krisxia0506/voxu/hardware/enclosure/README.md

# VOXU P2S 外壳 V4：上下壳卡扣，螺丝可选加固

按实物反馈更新的工程样机。只装 **51.45 × 28.33 mm ESP32 开发板、14 mm 圆形 INMP441 与直接焊接的排线**。拆掉两块板的排针，不再预留杜邦插头空间；有线供电，无电池、电源开关。

**本轮需要重打底座和上盖，配套使用。** 正常合盖使用四个一体打印卡扣，无需螺丝；四角原螺丝孔保留作额外加固。麦克风槽、按帽及默认最长顶杆保持原结构，按钮和可选麦克风框可以继续使用。用户已确认 USB 对位和麦克风直接卡装合适；新卡扣的实际手感、回弹和耐用性仍待验证。下载包内不含 G-code。

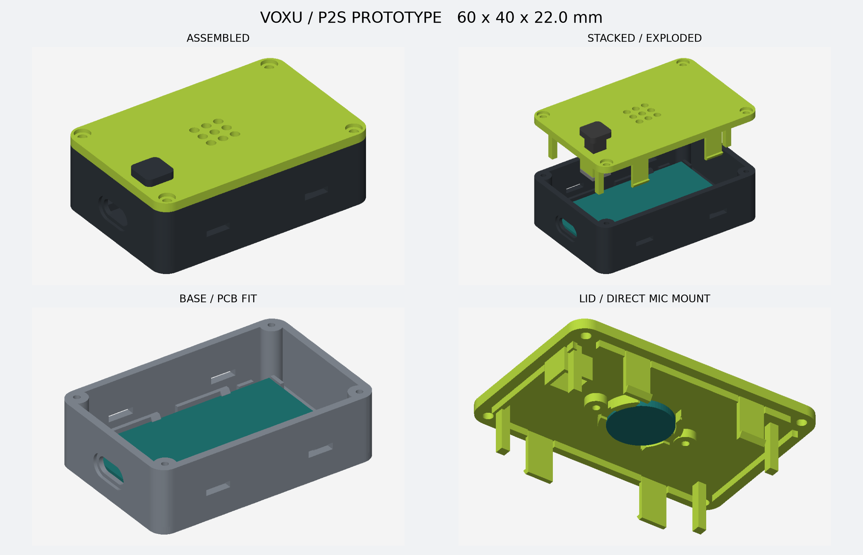
[picture p6: hardware/enclosure/preview.png]
实际 CAD 预览


## 这次改了什么

| 实物问题 | 当前结构 |
|---|---|
| 上下壳免螺丝安装 | 两条长边各 2 个卡扣，合盖时斜面导入并扣住侧壁；保留原螺丝孔，侧面留解锁孔便于拆盖 |
| 麦克风固定 | 用户实测现有槽可直接卡住，槽与螺钉座保持不变；`mic-clamp` 仅作可选加固 |
| 主板松动 | 4 个侧向弹性卡舌约束 PCB 边缘，无需靠上盖螺钉压紧才能定位；下方四个托台从 3 × 3 mm 向板内扩大为 6 × 6 mm |
| 按钮晃动、顶杆错位 | 5 mm 方形滑杆、5.4 mm 方孔，导向长度从 2.4 mm 增加到 8.0 mm；导向末端靠近 BOOT，限制倾斜和旋转 |
| 盒子太长 | 麦克风叠放在主板中央上方，长度从 88 mm 缩到 60 mm，避开远端天线区域；取消排针空间并降低托台 |
| USB 接口太深、开孔太大 | 按用户提供的突出 PCB 2 mm，主板前缘距壳外端面 2.4 mm，接口前端约内缩 0.4 mm；圆角通孔 9.8 × 4.2 mm |
| 9 个小孔被糊住 | 每孔直径从 1.2 mm 增加到 2.4 mm，孔距 3.4 mm，孔间保留 1 mm 实体 |

壳体外廓 **60 × 40 × 19.4 mm**，含未按下的按钮总高约 **22 mm**。上盖外表面平整，朝下贴板打印；无外侧护脊。

## 零件和额外材料

| 文件 | 数量 | 说明 |
|---|---:|---|
| `base.stl` | 1，本次重打 | 保留主板卡舌和 6 × 6 mm 托台，新增上盖卡扣接收/解锁孔 |
| `lid.stl` | 1，本次重打 | 新增 4 个一体卡扣，平面外表面仍朝下打印 |
| `mic-clamp.stl` | 可选 | 麦克风额外加固框，正常直接卡装时无需打印 |
| `button-cap.stl` | 1 | 按帽与长方形滑杆一体打印 |
| `button-pin.stl` | 1，可沿用旧最长件 | 用户实测所需的最长顶杆，已设为唯一默认件 |

上下壳正常卡合**不需要螺丝**。需要进一步加固时可加 **4 枚 M2×8 mm 塑料自攻螺钉**；麦克风加固框另可选 **2 枚 M2×5 mm 塑料自攻螺钉**。按帽与顶杆仍用少量适配打印材料的胶固定。上盖螺钉头径应不大于 4 mm。不要沿用旧版的 M2×10 当成新版指定长度。

## 打印顺序

P2S、0.4 mm 喷嘴、PLA、0.20 mm 层高、3 道墙、4 层顶底、15% 填充作为试装起点；需要在 Bambu Studio 选择实际材料。所有 STL 单位 mm，已摆正并落在 Z=0。

1. 从零组装只需底座、上盖、按帽和默认顶杆，共 4 件；麦克风加固框是可选件。已有旧版的用户本轮重打底座和上盖，旧最长顶杆及按帽继续使用。
2. `lid` 已按外表面朝下导出，内侧立柱、导向套、麦克风座和一体卡扣向上打印；关闭支撑，检查卡钩短悬挑是否成形。`button-cap` 顶面朝下、方杆向上，`mic-clamp` 平放，也关闭支撑。
3. 底座正放，卡舌横向弹臂下方与底板之间有 2 mm 间隙，需检查并清理该处支撑，让弹臂可向外弯曲，不能被支撑粘死。USB 窗口桥接和顶杆挡边悬挑也需检查支撑。首轮采用已切片验证的启用支撑配置。
4. 切片预览检查首层孔、孔口毛刺和支撑残留。几何检查不替代实际材料收缩、公差与打印质量验证。

## 装配顺序

1. **断电，拆排针并焊排线。** 将焊脚剪平，排线沿板侧绕到上盖；不能让排线横跨 BOOT 或压在 USB 接口、天线和麦克风声孔上。
2. 主板元件面朝上，先让 USB 对准端部开口，再把 PCB 四角压到扩大后的托台上。四个卡舌经斜面向外让位后扣住 PCB 两侧上缘。若卡舌不动，先清掉其下方支撑，不能强压 PCB。PCB 底面距壳底外表面 4 mm，底板厚 2 mm；焊点和线不能把 PCB 顶起来。取板时先用塑料片轻拨开卡舌再抬板，不要硬拔。
3. 上盖翻过来，将麦克风直接卡入已验证的定位座，无需加固框：**PCB 小声孔朝盖面，金属封装朝壳内**。将圆板旋转到两排焊点朝两个接线缺口。
4. 仅需进一步加固时放上 `mic-clamp`，两根向内伸出的短舌压住 PCB 左右边缘，中央大孔让开金属封装和焊点。用两枚 M2×5 螺钉交替轻拧，只拧到圆板不晃；不要压弯 PCB。压片按 1.6 mm PCB 厚度设计，若实际板更薄而有松动，可在两个边缘接触点各加薄垫片，避开声孔和焊点。
5. 从外侧插入按帽方杆，从内侧插入顶杆，先干试配合，再在顶杆短端末端点极少量胶，插入按帽孔至挡边贴住方杆底端。**必须穿过上盖后再粘接，不能在壳外先粘死**；胶不得流入方形导向孔。孔径 3.4 mm 配 3.0 mm 轴，带入口导角。胶固化后挡边与滑杆应成刚性整体，否则仍可能晃动。
6. 使用用户实测可用的最长顶杆（现名 `button-pin.stl`）。合盖前确认接触脚正对 BOOT，松手能回弹；主板卡到位后重新验证一次。不再提供多个长度供选。
7. 排线避开四个上盖卡扣。将上盖定位边对齐底座，在四个卡扣对应的位置逐一轻压，让斜面导入、卡钩进入侧壁小窗口。确认四周合缝、四个钩均扣住，再轻提上盖检查固定。若某处不入位，先检查毛刺/线材，不要用螺丝强行拉入卡扣。
8. 需要额外加固时再用原四角孔拧入 M2×8 螺钉；只需轻紧，不要使壳体变形。松开 BOOT 后通电，验证开始/结束与录音。
9. 拆盖时先卸掉可选加固螺丝、断电。从侧面小窗口用薄塑料片将对应卡钩向壳内推，同时轻抬该位置并用另一片塑料片保持约 1.5–2 mm 缝隙，逐一释放其余卡扣。只推卡钩，不要把工具深入壳内碰到排线/开发板；不要直接硬撬上盖。

## 尺寸来源与边界

- 用户确认开发板 51.45 × 28.33 mm、圆形麦克风 14 mm，并说明 USB-C 接口比 PCB 突出约 **2 mm**，本版据此前移主板。
- USB-C 插接界面有标准；本版参考 [GCT USB4105 厂商尺寸图](https://media.digikey.com/pdf/Data%20Sheets/GCT%20PDFs/USB4105%20-%20Product%20Drawing.pdf) 的金属壳约 **8.94 × 3.31 mm**，设计 **9.8 × 4.2 mm** 圆角孔。外侧另有深 0.8 mm、11.8 × 6.2 mm 的浅避让，让线头外包胶靠近端面。厂商图纸不是对实际板载连接器料号的认定。
- PCB 前缘位置 = `usb_protrusion + usb_front_recess` = 2 + 0.4 = 2.4 mm。接口高度暂按贴装在 PCB 元件面上设置，用实际底座验证插接。实际线头包胶外形并非所有线材相同。
- 上下壳新增 4 个卡扣，宽 6 mm、厚 1 mm、悬臂长约 10.2 mm；钩向外凸 0.8 mm，与底座内壁咬合约 0.5 mm。窗口每侧留 0.3 mm 横向间隙、上下各 0.2 mm 间隙。释放间隙检查采用 0.9 mm 端部内移包络，仅证明几何可通过，不代表有限元或材料寿命验证。
- 主板 4 个卡舌采用 12 mm 横向弹臂、1 mm 壁厚，卡唇在 PCB 上表面上方名义留 0.05 mm 间隙并向内覆盖 0.5 mm；几何检查确认能阻挡板子上抬。打印弹性、装入力与长期耐用性仍需实物验证。
- 两块 PCB 厚度暂按 1.6 mm；主板中央器件预留高 4.5 mm，麦克风封装碰撞检查使用 6 × 4 × 1.2 mm 包络，麦克风上方声腔间隙 0.4 mm。真实元件及焊线仍需试装。
- BOOT 中心暂按 PCB USB 端角向内 (3.1, 6.0) mm，高出 PCB 3.2 mm；按钮初始空隙 0.15 mm、按帽向下限位 0.6 mm，为可调整试装值。
- 平面尺寸参考：[开发板图](https://embedded-systems-design.github.io/overview-of-the-esp32-devkit-doit-v1/ESP32_dimension.png)、[麦克风图](https://components101.com/sites/default/files/inline-images/INMP441-Dimensions.jpg)。

## 生成和检查

```sh
python3 -m venv /tmp/voxu-cad
/tmp/voxu-cad/bin/pip install -r hardware/enclosure/requirements.txt
/tmp/voxu-cad/bin/python hardware/enclosure/generate.py
```

修改 `parameters.json` 再生成 STL、预览和压缩包。`validation.json` 包括 5 个零件（4 个必需件及 1 个可选麦克风加固框）的封闭性、单连通、正体积、USB 参考外壳/PCB/麦克风及压片装配干涉、默认最长顶杆 7 个行程位置、21 个插入位置、9 个声孔贯穿与主板卡舌阻挡上抬检查，以及 4 个外壳卡扣的锁止与 25 个拆出位置的释放间隙检查。

切片证据见 `slicer-result.json`：V4 上盖关闭支撑切片 Success，无支撑路径，约 27.6 分钟、6.8 g；新底座启用支撑切片 Success，约 35.3 分钟、13.5 g。未改变的按帽、最长顶杆和可选麦克风框不重复切片。卡扣的实际扣合、释放手感和耐用性尚未实物验证。

CLI 的机器指令解析曾出现 `Invalid T command (T65535)`，不交付其 G-code；请在 Bambu Studio 中从 STL 重新切片。几何、切片、实物装配与实际录音验证分别报告，当前仍是待实物验证的试装版。
