krisxia0506/voxu/hardware/integrated-pcba/economy-e1/README.md

# E1 经济型电气候选：超预算，未放行

核价日期：2026-10-24。目标为两块全部厂家焊接、合计160元以内，不付款。新电池按已确认要求单列。当前没有满足此目标的完整可生产方案；本目录不能下单制造。

## 已落实的改动

- 主控由WROOM-32E改为ESP32-PICO-V3（C967022，7×7 mm TFQFN48-EP）。依据[乐鑫数据手册v1.4](https://www.espressif.com/sites/default/files/documentation/esp32-pico_series_datasheet_en.pdf)映射电源、启动、UART、GPIO26/33及保留脚，保留经典蓝牙HFP/HID所需的ESP32架构。4MB Flash与晶振集成，但仍需PCB天线和匹配验证。
- 保留PDM麦克风、单USB-C充电/下载、电池电源路径、关机充电、USB域断电隔离。Type-C短边居中的机械要求继续有效；E1尚无新布局，不能把A2预览当成E1。
- 阻容优先采用基础库；ISET由8.66k单电阻改为8.2k+470Ω串联。含1%容差的最大电阻8756.7Ω，低于所引用的8900Ω推荐上限；沿用电流系数容差的充电电流计算为91.02–113.59mA。
- 增加局部去耦、Flash电压启动下拉及初始RF串联0Ω位置。共71位号、29料号。RF的0Ω只是调试初值，两个并联调谐位置暂不装，不能宣称无需射频调试。
- A2原生EDA工程、PCB和STEP备份保留。这里的KiCad原理图是交换草稿，尚未导入/验证为立创EDA专业版原生工程。

## 两块的费用：哪些已核，哪些还缺

在嘉立创原Y5草稿试换PICO-V3后，经济型、仅顶层、2片贴3片不贴，64/64位号可以选中。最终提交页显示：

| 费用 | 两块合计（元） |
|---|---:|
| 元件采购（含税、损耗、最低出库量） | 171.64 |
| 换料：12种×20 | 240.00 |
| 工程 | 50.00 |
| SMT焊盘 | 5.70 |
| X-RAY | 20.00 |
| DFM确认 | 3.00 |
| 氮气 | 5.20 |
| 页面SMT总计 | **495.54** |

这不是E1整板报价：旧Gerber/CPL仍是WROOM封装，且没有新增7个位号。不得提交此试算草稿。逐料号数量、价格复算171.6395元，与页面171.64元一致。

`costed-bom.csv`覆盖E1全部71位号、两板142个安装件，补入R25/R26/R27/C22–C25，并用基础库串联电阻替代R18。沿用当前已核价格/MOQ后，完整元件预算为**171.9707元**，预计剩11种收费料号、换料220元。新增件没有以0元略过；这是手工数量复算，未获新版BOM平台最终确认。

若暂按旧板PCB33元和试算加工费继承，E1账面参考为：171.97 + 220 + 50 + 5.70 + 20 + 3 + 5.20 + 33 = **508.87元**。这是跨版本预算参照，**不是最终总价、最低价或可成交报价**。新布局会改变焊点/加工核算，PCB券也未对新版验证。

| 未结清项目 | 状态；不得按0元算 |
|---|---|
| 新PCB、钢网/插件/分板等适用费用 | 必须用E1 Gerber和CPL重算；当前经济型页面未另列钢网/插件费 |
| PCB券 | 已领两张均为PCB券，SMT券为0；新订单是否抵扣尚未验证 |
| 运费 | 旧PCB报价京东特惠包邮；E1最终订单未确认，不能跨版本保证 |
| 固件/CP2102N配置写入 | 尚无验证配置镜像或厂家工序报价；焊好不等于烧录调试完成 |
| 射频匹配追加元件 | 实板/外壳调谐未完成，最终值和费用未定 |
| 两块新电池与匹配插头 | 按用户此前要求另计；型号、NTC、极性和价格未定 |

当前PICO路线即使免掉全部换料费，元件171.97元本身也超160元；不能承诺通过优惠满足预算。这只否定当前E1候选，不证明其他架构的全局最低价。

## 具体未完成项

1. 封装绑定、PCB天线、布局布线、原生ERC/DRC/DFM、3D及实板RF/电源/音频验证。U1/L1等未资格确认的封装留空，不沿用错误焊盘。
2. 输出电容的偏压有效容量、NRND供应风险、功率电感热参数及焊盘验证。保留功能是设计目标，尚未实板证明。
3. 旧平台坐标拒绝新增位号，明确提示“位号R26未能从位号文件中识别”。不能靠给新器件编造旧坐标获取制造放行。
4. 独立BOM上传尝试未收到文件选择事件，上传未成功；未声称已导入71位号。新版实际整板总价仍未取得。

## 本地验证

`python3 hardware/integrated-pcba/economy-e1/generate.py`检查引脚映射、保留脚、71件数量和ISET电阻容差。`checks.json`明确标记PCB NOT ROUTED、RF NOT VERIFIED、native ERC NOT RUN、manufacturing_release=false。该检查不能替代原生EDA电气检查或实板功能验证。

超预算，制作暂缓。没有新提交SMT订单，没有付款。
