krisxia0506/voxu/V1-DESIGN.md

# Voice Puck 外壳：当前 V4 工程样机

2026-09-29 最初选定 M 双层护脊外观；随后根据用户打印和装配反馈改为平面上盖，并在本轮改为焊线叠放的紧凑结构。历史概念图不再作为当前机械尺寸依据。

当前目标：拓竹 P2S；51.45 × 28.33 mm 开发板、14 mm 圆形 INMP441；去掉排针直接焊排线。板载 USB-C 有线供电，无电池、电源开关；外部按钮机械触动 BOOT。

[STL 下载包](hardware/enclosure/voxu-p2s-prototype.zip) · [打印装配说明](hardware/enclosure/README.md) · [参数](hardware/enclosure/parameters.json)

实际 CAD

- 壳体 60 × 40 × 19.4 mm，含按钮总高约 22 mm；麦克风叠放在主板中央上方，替代原 88 mm 长盒。
- 麦克风已由用户验证可直接卡入原槽，保留螺钉座及可选压片；拾音孔直径从 1.2 增到 2.4 mm，保留 9 孔。
- BOOT 使用 8.0 mm 长的方形导向套约束滑杆，内侧短顶杆胶接后防脱。
- 根据用户量到 USB-C 突出 PCB 约 2 mm，将主板前缘移至距壳外端面 2.4 mm；接口前端约内缩 0.4 mm，圆角通孔为 9.8 × 4.2 mm。
- 上盖外面平整，贴板打印。V4 上下壳增加四个可解锁卡扣，免螺丝压合，保留原四角螺丝孔供加固；本轮需重打底座和上盖，按帽与默认最长顶杆不变。

**状态：可打印试装模型，尚未实物验收。** PCB 厚度、BOOT 中心/高度、连接器安装高度及焊线空间仍有明确标注的假设。提供 4 个必需件和 1 个可选麦克风加固框，不提供 test 组件；主板新增 4 个侧向卡舌，下方托台由 3 × 3 mm 向内增至 6 × 6 mm。用户已验证麦克风卡装、USB 对位和最长顶杆，主板卡舌及新增上下壳卡扣的实物固定、释放和耐用性仍待验证。
