krisxia0506/voxu/hardware/integrated-pcba/procurement/economic-feasibility.md

# 经济型降本核算与制作暂停条件

核查日期：2026-10-24。用户最终要求：两块完整焊接 PCBA 合计 **160 元硬上限**，全部厂家焊接，超出暂缓制作。新电池按此前要求另计，但仍必须先列清；不付款。未提交新的 PCB 或 SMT 订单，原 Y5 未付款，旧 SMT 草稿不提交。

## 结论

**尚未找到满足预算且保留全部功能的经济型方案。已新增 E1 经济型电气候选与 71 位号 BOM；PCB 改版未完成，也没有新的完整成品实时报价。** 以下为选型门槛核算，不是可生产 BOM 或最终账单。现有 A2 源文件和 3D 备份继续保留，禁止将其视为经济型新版。

现有固件要求 Bluetooth Classic HFP + HID。不能用便宜的 ESP32-C3/S3 直接替代；其不支持 Classic，见 [乐鑫 Bluetooth 架构表](https://docs.espressif.com/projects/esp-idf/en/latest/esp32s3/api-guides/bt-architecture/overview.html)。改裸芯片还需要 Flash、晶振、射频匹配和天线设计验证，并非更换一个封装。

## 实查候选

国内嘉立创 SMT 目录网页人工可见结果；库存和含税价格只代表查询时点。没有“标准型专用”标签只表示可继续审核，**不等于已通过经济型订单匹配**。没有采购或预留这些候选。

| 料号 | 型号 | 页面单价/元 | 页面库存 | 资格与处理 |
| --- | --- | ---: | ---: | --- |
| [C701341](https://www.jlc-smt.com/lcsc/detail/C701341.html) | ESP32-WROOM-32E-N4 | 22.97 | 37863 | 标准型专用，旧方案不能只切换经济型选项 |
| [C19949066](https://www.jlc-smt.com/lcsc/detail/C19949066.html) | DOIT ESP32-32E-N4 | 19.07 | 845 | 标准型专用，不能解决经济型资格 |
| [C2764058](https://www.jlc-smt.com/lcsc/detail/C2764058.html) | ESP32-SL | 13.55 | 0 | 标准型专用、常规库存无货；共享库存2颗约29.64元，不采用 |
| [C193707](https://www.jlc-smt.com/lcsc/detail/C193707.html) | ESP32-PICO-D4 | 25.77 | 8466 | 标准型专用 |
| [C967022](https://www.jlc-smt.com/lcsc/detail/C967022.html) | ESP32-PICO-V3 | 25.48 | 798 | 扩展库、未见标准型专用标签；集成4MB Flash，需重新做射频及PCB |
| [C129733](https://www.jlc-smt.com/lcsc/detail/C129733.html) | ESP32-D0WDQ6 | 14.42 | 88 | 扩展库、未见标准型专用标签；需外部Flash、晶振、射频外围 |
| [C967020](https://www.jlc-smt.com/lcsc/detail/C967020.html) | ESP32-D0WDQ6-V3 | 18.29 | 2152 | 扩展库、未见标准型专用标签；同样需外部外围 |
| [C109322](https://www.jlc-smt.com/lcsc/detail/C109322.html) | TPS63070RNMR | 7.48 | 37038 | 扩展库、未见标准型专用标签；原电源候选 |

麦克风 SPH0655LM4H-1-8 / C22376158 沿用此前实际采购窗口 4.64 元快照，并非本轮重新预留；详见 microphone-selection.md。仍需下单前刷新。

## 预算门槛：先核算，再决定是否改版

[官方价格入口](https://www.jlc.com/)公开50元工程费起；[扩展库收费通知](https://www.jlc.com/portal/q7i36905.html)规定经济型20元/种。最终仍应以实际匹配和优惠抵扣后的页面为准。

以 PICO-V3 + 现有麦克风 + TPS63070 的三个扩展料号为例，不计损耗：

- 两块的这三颗芯片：2 × (25.48 + 4.64 + 7.48) = **75.20 元**。
- 工程费预算50元，三种换料费预算60元。
- 仅上述项目合计 **185.20 元**，已超160元25.20元。
- 尚未加入充电、UART、隔离、电感、阻容、连接器、开关、射频外围、PCB、焊点、检测、包装、运费、损耗及最低采购量。

这只排除了该候选组合在无减免下满足预算的可能，**不是证明所有经济型方案都不可能**。裸 ESP32-D0WDQ6 单价更低，但新增外围和扩展料号费用尚未核定，不能将14.42元当作完整主控成本。

## 盲盒领取后的复核（2026-10-24）

两次微信验证后，本月两张券已领取。客户中心“未使用/全部优惠券”共2条，均为 **PCB订单可用／1-6层板OSP EDA专用券**，有效期2026-10-24至2026-11-23；“未使用/SMT”共0条。第一张领取弹窗也明确“免费PCB，不免费SMT”。因此本次没有取得SMT加工减免，不能把工程或换料费抵扣为零。未使用券下单，也未付款。

[账户优惠券入口](https://member.jlc.com/integrated/content/couponList)。PCB是否能最终免单仍取决于新订单工艺和平台校验；两张券不能当作同一单的两次现金抵扣。

## 官方免换料费清单核对

已通过[专区](https://www.jlc-smt.com/lcsc/basic)“下载免换料费器件清单”取得xlsx，包含1586个器件；与旧BOM精确料号相交，11种/41个位号在清单内，17种/23个位号不在清单内。逐项结果见 `free-feeder-audit.csv`。清单不含库存和单价，也不证明经济型装配资格；不得据此宣布可生产。

可继续资格审核的替代候选（尚未写入生产BOM）：

| 原位置/功能 | 清单内候选 | 仍需审核 |
| --- | --- | --- |
| R5 2.21k | C4190，0603 2.2k 1% | 原电阻用途和电流裕量；相同电压下电流增加约0.455% |
| R18 8.66k ISET | 保留 C23114；基础库候选为8.2k+470Ω串联 | 撤销9.1k候选：超过设计引用的8.9k推荐上限。串联方案需新增位号和布局验证 |
| C1 1uF | C15849，0603 1uF 50V | 介质、偏压后容量和用途 |
| C15/C16 10uF | C15850，0805 10uF 25V（旧板已有） | 电源要求的有效容量、纹波与温度 |
| C17/C21 10uF | C96446，0603 10uF 25V | 有效容量、ESR和布局 |
| C18/C19/C20 22uF | C45783，0805 22uF 25V | 偏压后有效容量、容差及稳压器稳定性 |
| USB UART | C6568，CP2102-GMR | 不能直接替换CP2102N的充电检测/电流控制，需改电路与封装 |

前6行若全部通过，可减少6种收费料号，按经济型20元/种可少120元换料预算。但这是相对尚未优化的经济型BOM，并非从旧标准型224元换料费中扣120元，更不代表两块成品已低于160元。

## 硬上限复算与暂停依据

即使暂按PCB券完全抵扣板费，现有PICO候选的185.20元小计本来就未包含PCB，所以不会因只拿到PCB券而降到160元内。

另用本日已查的更低价裸芯片ESP32-D0WDQ6核算：若保留现选数字麦克风、USB-C及电池插座，并按四种非免换料料号计算，则工程50 + 换料4×20 + 两颗主控2×14.42 + 两颗麦克风2×4.64 = **168.12元**。此处连连接器本身、Flash、晶振、射频、电源、其余元件、焊点、损耗和运费均未加入；不是完整报价，也不是所有可能设计的理论最低价。它说明当前已查候选路线即使阻容全部免换料，仍不能满足160元。

因此继续保持制作暂停；没有以未完成的替代BOM提交订单。全功能合格经济型改版和完整实际总价仍未取得，不声称完成。若要继续寻找不同主控/模拟麦克风/电源架构，须重新评估功能和录音性能，不能将当前小计包装为可下单方案。

## 旧方案费用复算（历史报价，不用于新下单）

64个贴装位号单价来自 jlc-order-review.json，装在一块上的元件合计94.5043元，两块189.0086元。平台元件实际计价243.19元，差额54.1814元包含采购数量/损耗影响，不能按只买恰好两份计算。

| 旧标准型两块项目 | 元 |
| --- | ---: |
| 元件采购 | 243.19 |
| 工程 | 150.00 |
| 换料 | 224.00 |
| 钢网 | 50.00 |
| 焊点 | 5.66 |
| X-ray | 20.00 |
| 包装 | 3.01 |
| 差价（平台未解释明细） | 54.23 |
| DFM确认 | 3.00 |
| SMT小计 | 753.09 |
| PCB参考价 | 33.00 |
| 合计参考 | **786.09** |

电池、烧录及最终运费/审核调整未包含。旧PCB33元含20元板费、10元品质赔付、3元生产稿复核；不能直接将旧PCB金额套入新版，也不能把非必要附加服务当作必选费用。

## 后续降本门槛及未完成项

1. 首先确认经济型可贴主控；保留 Classic 功能。只有成本表可落在160元内才进入该路线完整改版。
2. 优先消除不必要扩展料号：2.21k/8.66k电阻改常用基础库阻值须重算VBUS检测分压/充电电流；电容统一基础库须核对偏压后有效容量和电源稳定性；不能只按标称容量替换。
3. 原21.55元 Coilcraft 电感是重点降本项；替代须满足饱和电流、温升电流、DCR和开关频率，不能换成普通射频0402电感。
4. UART便宜替换不能丢失USB限流控制、断电隔离；CP2102N配置及烧录成本仍待闭合。充电器须保留合规电流与真实电池温度监测。
5. 全部开关、Type-C和电池连接器都必须厂家焊好；不把手焊元件从报价删掉来满足预算。Type-C短边居中继续保留。
6. 最终费用必须逐项列出：最低PCB批量、两块装配、采购损耗/MOQ、换料、工程、钢网、检测、包装运费、烧录及电池。未知项保持未知，不填零。160元上限不得以多做板子后摊薄单价代替。

**当前制作暂缓，未放行。** 不因需要平台后续审核或付款后DFM而付款；新完整BOM、经济型匹配报价、制造检查和实板验证均未完成。

## 全部64位号核价试验（2026-10-24，未提交）

本次在平台报价草稿中实际替换10个位号，保留全部64个贴装位置；源PCB未改，草稿禁止直接提交制造。

- R5：C22903 → C4190（2.2k基础库，VBUS检测分压）。
- C1：C29936 → C15849（1uF 50V X5R基础库）。
- C15/C16：C109040 → C15850（与已有0805 10uF合并）。
- C17/C21：C386081 → C96446（0603 10uF基础库）。
- C18/C19/C20：C258782 → C45783（0805 22uF基础库）。
- L1：C3033018 → C5127348（1.5uH，6A Isat，46mΩ，4.6×4.2mm，0.382元；必须重新绑定封装和检查电源，尚未资格签核）。

阻容替换减少5种扩展料号。R18没有采用错误的9.1k候选。输出电容的偏压后有效容量/温度范围尚待确认，C45783厂家标为NRND；便宜电感的温升规格在目录标题与描述有差异。这些是成本候选而非制造放行。

其余器件未删除：主控、麦克风、USB-UART、3颗断电隔离缓冲、充电和升降压、电源保护、全部开关及连接器均包含。CP2102不能直接替代CP2102N的充电识别；TP4056不能直接替代带电源路径和温度监测的BQ24075；没有把这些非等价更换算作已优化。

完整明细见 cost-trial-all-parts.csv：64个位号、27种料号，128个实际焊接元件，按平台采购损耗/MOQ计价，逐料号去重后合计185.1188元，与平台185.12元一致。表内重复位号共享同种料的采购数量，不能重复累加。

| 完整BOM核价试验项目 | CNY | 性质 |
| --- | ---: | --- |
| 全部元件采购含损耗/MOQ | 185.12 | 平台实时显示，已逐项复算 |
| SMT加工 | 447.67 | 两块、标准型、仅顶层、普通2-3天；平台汇总 |
| SMT合计 | 632.79 | 未提交核价草稿，不是已审核可生产报价 |
| 旧PCB订单参考 | 33.00 | 历史订单含可选附加项，不是本轮最低板价 |
| 沿用旧PCB金额的合计 | 665.79 | 仅跨单参考，不得称最低到手价 |
| PCB券抵扣、最终运费、烧录 | 未确认 | 不填零；电池按用户要求另计 |

旧SMT753.09元与试算632.79元相比少120.30元。页面另显示经济型485.25元，但现用WROOM在经济型不可选；这个数字不能冒充两块完整焊好的经济型价格。切换产品类型曾重置贴装数量，已恢复并检查两块、顶层、普通交期；未以五块报价摊薄。

**尚未完成用户要求的“合格经济型完整最低总价”。** 本次取得的是覆盖全BOM的标准型降本试算，不能把它说成最低方案，也不能把632.79元当包含PCB和运费的到手总价。当前路线显著超160元，继续暂停制作、不付款。若继续经济型路线，需要完成支持Classic的主控/RF改版、替代元件资格核验，再获取全部费用；现有文件和旧订单都不应放行。

## E1 经济型实际选料与全 BOM 预算（本轮更新）

见 `../economy-e1/README.md`。C967022 / ESP32-PICO-V3 已在两块、仅顶层、经济型模式下通过平台选料，64/64 位号可选；此结论取代上文“只查到目录标签”的早期状态。最终提交页试算495.54元，但使用旧A2坐标，不能制造或称为E1最终报价。

E1 已生成71位号电气候选、原理图交换文件和29料号完整成本表，两板142个安装件，含已知损耗/MOQ的元件预算171.9707元。R18改为8.2k+470Ω串联，换料预算从240降为220元。其余加工、PCB、运费和配置工序的核价状态逐项列在E1说明中；未把缺失费用记零。未下单、未付款，继续因160元上限暂缓制作。

额外发现免换料清单内的USB ESD候选C7420376 / SRV05-4（0.494元，库存128347，损耗4、最小贴装5，2026-10-24选料页），但尚未验证引脚和USB电气规格，未当成等价替代写进E1。不是所有保护器件都没有免换料候选。
