krisxia0506/voxu/hardware/integrated-pcba/procurement/microphone-selection.md

# 麦克风供货与性价比选择

2026-10-23，按用户允许改用嘉立创现货、降低成本的要求，选择 **Knowles SPH0655LM4H-1-8，C22376158** 作为下一版麦克风。尚未采购或预留库存，未付款。

## 国内 SMT 实查

| 型号 | 含税单颗价（1+） | 购买窗口可预售库存 | 页面换料费 | 判断 |
| --- | ---: | ---: | --- | --- |
| [SPH0655LM4H-1-8](https://www.jlc-smt.com/lcsc/detail/C22376158.html) | ¥4.64 | 3482 | 经济型 ¥20 / 标准型 ¥8 | 首选，PDM，标称 66 dB |
| [MSM261DGT003](https://www.jlc-smt.com/lcsc/detail/C48227730.html) | ¥5.47 | 2513 | 经济型 ¥20 / 标准型 ¥8 | 备选，PDM，目录 64 dB |

详情页库存总量分别为 3951、2829，不能将总量等同可购买量。以上以打开购买窗口后显示的「可预售库存」为准；没有点击加入预订购物车或结算。价格与库存会变化。

I2S 搜索结果中，ICS-43434 C5656610 的 1+ 价为 ¥28.13、目录库存 4042；尚未复核其购买窗口，不作为已确认可购买的备选。GSA3526H10-B26-5PI2S-JSM C55497034 虽显示总量 5、参考价 ¥4.50，购买窗口只有预订且最低 12 颗，不能当即用现货。原 INMP441 与 MSM261S4030H0R 无可购买现货。

一块板使用一颗麦克风：仅该料的单颗价加页面经济型换料费为 **¥24.64**，标准型为 **¥12.64**。这两个数字均不是 SMT 总价，未包含损耗、最低备料数量、焊点、钢网、开机、PCB、运费，也未核定优惠。标准型其他固定费用可能不同，不能仅凭换料费判断整板更便宜。

## 电气依据与替换约束

厂家 [SPH0655LM4H-1 Rev D 数据手册（商城提供）](https://atta.szlcsc.com/upload/public/pdf/source/20250721/5475C98035E60ADDD1C93C8246A1E933.pdf) 第 2、3、5 页已核对：

- 供电范围 1.65–3.6 V，可接本板 3.3 V。商品标题的 1.8 V 是典型值，不是供电上限。
- PDM 单比特输出，底部进音；3.5 × 2.65 × 0.98 mm。封装与 INMP441 不同，必须替换准确焊盘并复核声孔。
- 正常模式时钟范围 1.1–4.8 MHz；低功耗模式 0.5–0.9 MHz。
- 正常模式在 1.536、2.4、3.072、4.8 MHz 的标称信噪比为 66 dB(A)，1.2 MHz 为 64.5 dB(A)。这些是规定条件下的典型值，不能承诺装板录音效果。
- 1.8 V、2.4 MHz 条件下典型电流 1 mA，灵敏度 -37 dBFS；需实测并调整录音增益，不能照搬 INMP441 的幅度转换。

当前 ESP32 的 I2S0 支持硬件 PDM-to-PCM，见 [ESP-IDF I2S 文档](https://docs.espressif.com/projects/esp-idf/en/release-v5.5/esp32/api-reference/peripherals/i2s.html)。可继续输出 16 kHz PCM，无需新增外部 ADC，但必须修改驱动与 PCB：

1. 使用 PDM RX、16 位 PCM，复核 SELECT 电平、采样边沿与左右槽映射。
2. 16 kHz 时应选 128 倍抽取（`I2S_PDM_DSR_16S`），得到 2.048 MHz 时钟。默认 64 倍为 1.024 MHz，落在本麦克风两工作模式之间，**不可直接沿用默认配置**。2.048 MHz 的实际 SNR 不按表中其他时钟点直接宣称为已验证值。
3. 时钟、数据与供电重新连接；原 I2S WS 不再使用。保留原 INMP441 面包板固件的独立构建配置。
4. 更换原理图、PCB 封装及 3D 模型，复核声孔、阻焊和钢网，重新跑网络比对与 DRC，重新导出 BOM/CPL/制造文件。
5. 再进行一块成品的实际报价和样板录音验证。

**实施状态：已落板。** 原生 U2、5 个逻辑引脚（GND 分为 4 块实体焊盘）、0.65 mm 非金属化声孔、3D 模型与 CPL 均已替换。声孔处旧控制线已绕行，重建双面地铜后 PCB DRC 为 141 项、0 问题（2026-10-23 22:24:13）。213 个连接引脚与规范电气清单逐项一致。原理图 DRC 为 0 错误、0 警告，三条连接器/开关机械焊盘映射信息另列。

`i2s-smoke` 和 `hfp-probe` 的新 `pcba-sph0655`、旧 `esp32dev` 四个构建全部通过。新配置使用 PDM RX、16 位 PCM、128 倍抽取、LEFT 槽，启动和唤醒后丢弃 40 ms 样本。编译不代表音频硬件已验证；声孔钢网/DFM、厂家贴装方向和实物录音测试仍待完成。
