krisxia0506/voxu/docs/superpowers/research/2026-09-30-rejected-modular-spec.md

> 历史存档：用户已于 2026-09-30 否决该大尺寸模块方案，并要求兼容多种充电器。以下不是当前设计，也不是采购/接线依据。当前规格见 [紧凑单口电池版](../specs/2026-09-30-single-usbc-battery-design.md)。

# VOXU 单 USB-C 电池版设计规格

日期：2026-09-30。基线：`7c86af2`（已合入 PR #3 外壳与 PR #4 自动重连）。

**状态：已按用户要求改为无模式切换的自动充电目标；自动识别电路尚未定型，尚未生成电池版 CAD、STL 或完成电气实测。**
本文中的尺寸和工作指标是后续实施的输入，不是实测结果。原 USB 版模型继续保留。

## 1. 已确认的目标

- 复用现有 ESP32-WROOM-32、30 针 USB-C 开发板及 14 mm 圆形 INMP441。
- 不更换主控，不丢失 BOOT 开始/结束操作和上次蓝牙设备自动重连功能。
- 电池运行目标为持续连接、使用麦克风约 4–6 小时；接受外壳加大。
- **复用开发板现有 USB-C 接口**进行充电、供电与刷机，不在外壳增加充电口。
- 主要电脑为用户已确认的 **MacBook 自带 USB-C**；仍需验证实际端口供电声明。
- **接电脑可充电、刷机，接充电器可充电，全程不用切换模式。** 保留原 USB 数据能力；不要求先用充电器恢复电量才能接电脑刷机。
- 支持供电能力足够时边充边用，以及关闭麦克风整机时充电。低功率端口自动降低充电电流；必须明确实测兼容范围，不能将电池持续放电称为边充边用。
- 交付明确料号的 BOM、接线/装配说明、可编辑 CAD 生成脚本、STL、实际 CAD 预览和打印包。
- 使用 P2S；延续平面上盖、麦克风固定座、BOOT 导向按键、可解锁卡扣与可选螺钉加固。

## 2. 实物证据与设计边界

用户实测开发板 51.45 × 28.33 mm、USB-C 前端突出 PCB 约 2 mm。照片可见 VIN、3V3、EN、BOOT、PWR、D2，布局符合 CH340 USB-C 的 30 针 DevKit V1 类板。

[Micro Robotics 板型资料](https://www.robotics.org.za/development-boards/ESP32-DEV)给出 51.5 × 28.5 mm、30 针、CH340 和 USB-C；作为板型识别参考，不代替用户尺寸。
[同类板实物追线记录](https://diyelectromusic.com/2024/12/07/esp32-wroom-mozzi-experimenter-pcb-design/)给出 USB VBUS → SS14 → VIN → 3.3 V 稳压器的电路，也明确存在 USB 与 VIN 直连的变体。

因此按下面的**电气节点契约**设计，不能仅凭网络图片指定用户板上的某个器件一定要拆。焊接前核对实际电源网属于装配验收项，不阻止 BOM、CAD 和说明的制作。

## 3. 选型与取舍

**BQ24074 负载分配充电板 + PowerBoost 1000 Basic 升压板暂作为电源路径候选，不是可直接采购装配的完整方案。** BQ24074 不会自行识别电脑/充电器及其允许电流；原来的手动模式方案已被用户否决，必须补齐自动识别与限流控制后才能冻结选型。此前讨论的 PowerBoost 1000C 也不能直接替代这一功能。

| 方案 | 判断 |
| --- | --- |
| BQ24074 + 独立可关断升压板 | 候选电源路径，尚缺自动识别控制；有公开原理图和 PCB，充电、输入限流、温度检测及系统开关各自可控；代价是两块板和较大的外壳 |
| PowerBoost 1000C 一体板 | 集成度较高，但默认充电/输入电流不能直接当作普通电脑 USB 端口已授权的大电流负载；本版不采用 |
| 定制充电升压 PCB | 可以集成自动识别与电源管理并减小体积；需要打板和电气验证，是否采用待可用模块调查后确定 |

### 候选 BOM（每台，尚不可直接按表装配）

| 元器件/模块 | 数量 | 本版规格与用途 |
| --- | ---: | --- |
| 现有 ESP32 开发板 | 1 | 去排针、焊短线，PCB 51.45 × 28.33 mm |
| 现有 INMP441 圆板 | 1 | 保持 GPIO26/25/33 与 3V3 接线 |
| [Adafruit BQ24074 #4755](https://www.adafruit.com/product/4755) | 1 | 单节 4.2 V 锂电充电、负载分配；PCB 源文件轮廓 38.10 × 33.02 mm；自带 USB-C/DC 插座藏在壳内，不接外部线 |
| [Adafruit PowerBoost 1000 Basic #2030](https://www.adafruit.com/product/2030) | 1 | 升压输出约 5.2 V，EN 拉低可断开输出；参考外廓 29 × 23 mm；不装随附 USB-A、JST 或接线端子，直接焊线 |
| [Adafruit 2500mAh 单节保护电池 #328](https://www.adafruit.com/product/328) | 1 | 标称 3.7 V，满电 4.2 V；参考尺寸 60 × 50 × 7.3 mm；允许充电电流不超过 1.2 A；自带保护与 JST-PH 插头 |
| [SPDT 滑动开关 #805](https://www.adafruit.com/product/805) | 1 | 仅控制运行开关；不设置电脑/充电器模式开关 |
| [10 kΩ NTC #372](https://www.adafruit.com/product/372) | 1 | 按 #4755 指南接 THERM；贴靠电池大面，绝缘固定，不压迫软包 |
| 自动 USB 电源识别及限流控制电路 | 待定 | 检测电源允许电流、控制充电输入限制，并保留 USB 数据；完整料号、尺寸和接线尚未定型 |
| 绝缘导线、热缩管、聚酰亚胺胶带 | 1 套 | 电源线 22–24 AWG；控制与 I²S 用细软线；接点绝缘并设置应力释放 |
| 薄泡棉边垫、可拆束带 | 1 套 | 固定电池边缘，限制晃动，不挤压软包；线缆不跨电池大面承压 |
| M2 螺钉/固定小件 | 按最终 CAD | 数量、长度由穿透/干涉验证后写入实施 BOM；不得照搬 USB 版螺钉长度 |
| USB 5 V ≥1 A 电源及数据线 | 各 1 | 充电使用普通 5 V 电源，不增加 PD 高压诱骗；刷机线需支持数据 |

上述国际品牌料号用于建立可追溯的电气/尺寸基线，不代表已核实国内现货或最低价格。替换成其他模块须重新核对电路、引脚、保护、限流与尺寸，不能只按芯片名称替换。

## 4. 电源连接与单口改造

```text
                         原板 USB 数据线 ────────── 原 USB-UART / ESP32
现有 USB-C VBUS
      │ RAW_USB_5V（必须只来自外部 USB）
      ▼
BQ24074 VBUS ── 输入电流控制 / 负载分配 ── OUT（约电池电压至 4.4 V）
                     ↕                            │
               LIPO / BATT                        ▼
               保护电池                 PowerBoost Basic 输入 BAT
                                                  │ 约 5.2 V
                                                  ▼
                                        SYS_5V → 开发板 VIN
                                                  ▼
                                        原板稳压器 → 3V3 → ESP32 / INMP441
所有 GND 共地
```

必须满足以下约束：

1. 将原来 RAW_USB_5V 到系统 VIN 的直供通路断开。若经串联二极管连接，可在确认两侧网络后拆下该器件，将 USB 侧作为充电输入、系统侧作为升压输出；若是直连版本，需单独确定可恢复的隔离改造位置。不得仅增加一条充电飞线而保留闭合回路。
2. 升压输出只接系统 VIN，不能接 RAW_USB_5V，不能接充电板 VBUS，也不能接 ESP32 3V3。电池不得直接接开发板 VIN 或 3V3。
3. 原板 USB-UART 的供电必须追线记录：若来自系统电源，保留；若来自 RAW_USB_5V，需验证关机时 TX/DTR/RTS 不会向已断电的 ESP32 灌电，必要时一并迁移其供电到合适的系统电源节点。不能在未验证前宣称关机完全断电。
4. 保留 USB 数据通信和原有自动下载能力。若加入 BC1.2 检测，必须验证检测时序与 USB-UART 的数据连接互不干扰；若加入 Type-C CC 控制器，按其要求处理原板 CC 下拉，不能重复并联终端电阻。不能将候选充电模块的数据焊盘当作通用识别输入。充电板自带接口不再对外开放，避免第二路外接电源。
5. BAT/LIPO、OUT 和 VBUS 是不同网络。必须按实物丝印复核电池插头极性；同为 JST-PH 不保证正负一致。
6. RAW_USB_5V 与 SYS_5V 的隔离、电源极性和短路检查通过后，才能首次连接电池；初次上电先用限流电源进行无电池调试。

## 5. 操作、限流与开关

用户已明确要求自动操作，**不设置 PC/CHARGE 开关**。以下是验收要求，不代表候选模块已经实现。

| 接入状态 | 预期行为 |
| --- | --- |
| 电脑 USB + 数据线 | 自动供电/充电并支持刷机；不需拔电池或切模式。按端口允许电流限制总输入，刷机时仍可充电 |
| USB 充电器 | 自动充电；供电足够时支持持续使用麦克风且电池净充电 |
| 拔掉 USB | 运行开关 ON 时自动使用电池，不因拔线重启 |
| 运行开关 OFF + USB | 保持电池充电；重新开机不需选择电源模式 |
| 低电量或电池保护后接电脑 | 应有外部电源恢复路径，不能依赖已经运行的 ESP32 才能打开充电；恢复条件和等待时间需实测 |

### 自动控制电路的待解决事项

1. **Type-C 电流识别**：TI TUSB320 类器件能够读取 CC 上的默认、1.5 A、3 A 电流声明，但不等于充电器，也不能仅凭默认声明假设已获得大电流许可。需要核对原板 CC 节点是否可接入、原有下拉如何处理，以及无需电池即可工作的启动电源。
2. **传统 USB 电源识别及数据兼容**：BC1.2 检测可识别部分充电端口，但普通数据端口仍涉及 USB 枚举、电流申请与挂起行为。不能把识别到 SDP 等同于原 CH340 已申请 500 mA；需读取实际 USB 描述符并核实配置后的电流预算。检测过程必须保留刷机连接。
3. **可选集成路径**：BQ25606 等芯片具有电源路径与 D+/D− 输入识别，可作为替代候选；仅查到芯片功能不足以认定现成模块可用。需核实模块完整原理图、默认限流、USB 数据共存、关机充电、系统输出及尺寸。不得用其面向 USB VBUS 的 OTG 升压替代本设计的隔离系统输出而导致反向供电。
4. **总输入预算**：限流必须覆盖系统、USB-UART 和充电的总消耗。电源较弱时优先维持系统，自动减小充电电流；若电池仍净放电，应记录为该端口不满足运行中充电要求，不能以亮充电灯作为通过依据。
5. **失效与启动默认值**：电源识别未完成、控制器复位、USB 挂起或拔插时应有确定的限流状态；不依赖用户切换，也不能依赖主固件先启动才能充电。

BQ24074 若继续采用，其 EN1/EN2 应由确定的自动控制电路驱动，旧版固定 EN1 加手动 EN2 接法作废。电池充电电流暂以 0.5 A 为预算上限，最终值不得超过电池规格；输入限流与电池充电电流分别计算。自动电路未定型前，不发布最终焊接步骤或宣称满足电脑边充边刷。

运行开关：公共端接 PowerBoost EN，OFF 端接 GND，ON 端悬空并利用板上默认上拉；它关闭升压输出，充电板和电池保护仍工作。这不是运输/维修用电池物理隔离；拆装前拔下电池和 USB。

切断充电板 THERM 默认旁路，按厂家指南接 10 kΩ NTC 到 THERM/GND。温度检测和电池保护都必须实际验证，不将充电芯片热限流当作电池温度保护。

## 6. 续航与热设计预算

电池名义能量为 2.5 Ah × 3.7 V = 9.25 Wh。初估升压效率取 85%，可用容量取额定的 80%，系统输入取 5.2 V：

`估算小时 = 2.5 × 3.7 × 0.85 × 0.80 / (5.2 × 实测系统平均电流A)`

| 系统 5.2 V 平均电流（包含开发板与麦克风） | 初估续航 |
| --- | ---: |
| 0.20 A | 6.05 h |
| 0.25 A | 4.84 h |
| 0.30 A | 4.03 h |

这些电流不是已有测量。若实测平均电流高于约 0.30 A、低温/电池衰减或转换损耗使连续工作不足 4 小时，目标未达成，必须优化耗电或增加容量并重做电池仓。

接电脑或充电器时都应分别确认平均电池电流确实流入电池；单看充电灯不能证明“边充边用”。输入供应不足时电源路径可能由电池补充，不能将此状态算作达标。实测全负载/充电温升、供电波形及录音噪声；软包与热源之间设置独立隔板和空气间隙。

## 7. 外壳布局与外观

外形为圆角方盒、平面上盖，顶部保留 BOOT 按帽与 9 孔拾音区，侧面为原 USB-C 和运行开关，不开模式开关孔；通过小窗口查看电源/充电状态。避免把升压板电感放在麦克风旁。

现成模块分层布局占位 **约 86 × 96 × 41.4 mm**，不是最终打印尺寸，连接器和控制小板的完整实体尺寸仍需核对，不能冻结外壳。此尺寸替代先前 80 × 88 × 42 mm 的预算，增加了自动检测板及控制板占位。若 CAD 能在满足间隙的前提下缩小则收紧，不能以缩小外壳为理由压迫电池。

- 底层：独立电池浅仓，预留电池制造公差、软包非挤压间隙、保护板与 JST 线出口，使用可拆固定带；螺钉、焊脚、卡扣和工具释放路径均不能进入电池包络。
- 上层前区：沿用原 ESP32 的 USB 对位、PCB 边缘固定和 BOOT 导向的相对位置，模块去排针焊线。
- 上层侧区：BQ24074 与升压板分区固定，保留其连接器实体、元件高度和线材弯折空间。外壳不为充电板自带 USB/DC 插座开孔。
- 主板天线端预留无金属区域，初始按距电池/导线/电源板至少 15 mm 的空间设计；最终参考 ESP32 模组天线布局指南逐项检查，不能只检查 PCB 彼此不相交。
- 麦克风仍贴上盖，PCB 声孔朝外；保留现有已验证的卡槽与可选压框、2.4 mm 声孔。
- 采用可解锁卡扣和可选螺钉加固；电池仓与电子件间用可拆托盘隔离。只交付实际装配零件，不增加无关试块。
- STL 按打印方向落在 Z=0；上盖外平面贴板打印。底座、托盘及各卡扣的支撑需求必须通过 P2S 切片检查后写入说明。

## 8. 实施产物与验收

后续新增 `hardware/battery/`（BOM、接线、装配、电源证据）与 `hardware/enclosure-battery/`（参数、生成脚本、STL、验证、预览、ZIP），更新根目录文档指向两个版本。不得把 USB 版 STL 覆盖成电池版。保持现有音频/按键/重连固件行为；本版不加入未经校准的电量百分比显示。

### 可以在本地完成的验证

1. CAD 生成可复现；所有零件封闭、正体积、法向一致、连通性符合实际零件数。
2. 组件实体与外壳/托盘、走线、电池保护空间、天线避让区无非预期干涉。
3. USB 插头插入、开关全行程、BOOT 行程、上盖合装与释放、螺钉长度及麦克风声孔贯通检查。
4. P2S 切片验证全部需打印零件，区分需支撑与无需支撑；只交付 STL/源码/预览，不将未验证 G-code 作为成品。
5. 打印包清单与当前 CAD 参数一致，链接和文档一致；现有两项固件主机回归继续通过。

### 必须由实物证明的验收

1. 原板电源网与隔离点已确认；电池供电时 USB VBUS 无可驱动的反向电压，充电输入不被升压输出回灌。
2. 空载、开机、蓝牙重连、持续采音和 USB 插拔状态供电稳定，无欠压复位；USB 刷机和 BOOT 操作正常。
3. 分别用电脑数据端口、支持充电的电脑端口、USB-A 充电器及 USB-C 充电器测试：自动充电、电脑刷机、OFF 时充电、低电量恢复均不需切模式。记录端口声明/枚举预算、总输入和电池净电流；目标边充边用端口必须在持续采音时电池净充电。弱端口限流、USB 挂起、插拔和重新枚举也需验证。
4. 电池 NTC 温度保护、充电终止、保护板低压切断/恢复以及系统关机行为符合器件规格。
5. 连续蓝牙麦克风使用至少 4 小时；完整记录负载、时间、电量终点、平均电流、环境/电池/电源板温度，不将计算值替代实测。
6. 实物装配不卡线、不压电池；USB 插接、按钮回弹、开关操作、卡扣拆装和蓝牙距离/音频噪声通过比较验证。

本地几何通过、切片成功、电气实测与续航达标分别报告。任何未完成项保留为未完成，PR 保持 Draft，不把设计资料可下载表述为整机已经验证完成。

## 9. 原始资料

- [BQ24074 引脚、限流跳线与 NTC 接法](https://learn.adafruit.com/adafruit-bq24074-universal-usb-dc-solar-charger-breakout/pinouts)
- [BQ24074 原理图和 PCB 源文件](https://github.com/adafruit/Adafruit-BQ24074-PCB)
- [TI BQ2407x 数据手册](https://www.ti.com/lit/ds/symlink/bq24074.pdf)：EN1/EN2 模式、standby 下 OUT 接电池、输入 DPM 和负载优先。
- [PowerBoost Basic 模块资料](https://www.adafruit.com/product/2030)及[PCB 源文件](https://github.com/adafruit/Adafruit-PowerBoost-1000-PCB)
- [电池 #328 尺寸、保护与最大充电电流](https://www.adafruit.com/product/328)
- [ESP32-WROOM-32 数据手册](https://documentation.espressif.com/esp32-wroom-32_datasheet_en.pdf)

- [TI TUSB320 产品资料](https://www.ti.com/product/TUSB320)：Type-C CC 电流模式识别。
- [TI BQ25606 产品资料](https://www.ti.com/product/BQ25606)：集成电源路径与 USB 输入识别的候选。
- [TI 关于 BQ25606 数据线检测与 USB 通信的说明](https://e2e.ti.com/support/power-management-group/power-management/f/power-management-forum/731136/bq25606-charging-current-doesn-t-go-higher-than-500-ma)：检测与数据通信的时序需要配合。

## 10. 当前决定与后续工程事项

用户已确认单口、接电脑充电并刷机、接充电器充电、全程无需切模式。旧版“电脑不充电”的方案废止，不再要求用户确认这一取舍。

下一步需确定可实施的自动识别电路、实际 USB 电流预算和低电量启动路径，再冻结 BOM 与外壳尺寸。当前约 86 × 96 × 41.4 mm 仅为现成候选组件的分层占位，尚无最终 CAD、打印包或电气验证结论。

选型调查见 [USB-C 自动充电模块证据](../research/2026-09-30-usbc-power-options.md)，包含 HUSB238 输出开关限制、PTN5150A 无电池接入能力及 FT231X 备用方案。

现成模块的 [分层布局提案](../research/2026-09-30-battery-layout-proposal.md) 已绘制为约 **86 × 96 × 41.4 mm** 占位，替代 80 × 88 × 42 mm 的旧口头预算；包含未验证连接器、控制小板和天线假设，尚未冻结最终外形。

只读 USB 检查发现当前主机一个 WCH `1a86:7523` 设备的 `bMaxPower=49`（98 mA）。详见 [证据记录](../research/2026-09-30-usb-readonly-evidence.json)；与照片板的对应关系和 CC 授权尚未确认，不能据此假设已有 500 mA 枚举预算。

文中仓库提交标识已更新为隐私清理后的对应提交；历史设计结论未重新验证。
