krisxia0506/voxu/hardware/enclosure-battery/preview-template.html

# VOXU 分层装配

ESP32 卡扣转角修正版 8 · 62 × 46 × 31.4 mm
真实 CAD 网格 · 离线可用

拆解程度 0%

合拢完全拆解只看底座只看电源层元件位置连线标记：关螺丝孔位重置视角

显示零件

拖动旋转，滚轮缩放。拆解沿竖直方向展示层次，不代表实际拆装路径。电子件为外形包络；固定强度需打印试装确认。

底壳硬限位承受 USB 插拔；两片蓝色压片扣住 UPS 板边。右侧金色为 SS12D00G3，粉色为开关压盖。新增压件共用 4 枚 M2×4 平尾塑料自攻螺丝。

装配：先开关、UPS和压件，再装主板。拆卸外侧压片：卸螺丝后向侧壁退约 0.9 mm，再向上取出。外置开关接 SW/G 已由用户验证启停可用，详见接线演示。

金色十字头为12枚螺丝：UPS压片2、开关压盖2、托盘2、麦克风压框2（以上M2×4），上盖四角4（M2×8，可选加固）。托盘和麦克风螺丝从下向上安装。螺丝为简化外形，不含螺纹，不用于打印；头部按直径4mm、高1.5mm包络展示。

第8版：只重打底壳。ESP32四个卡扣内角增加R2圆弧，靠UPS一侧立柱接满横臂高度。清净圆弧下方支撑，轻拨扣唇装拆，实物强度待试装。

沿用第7版尺寸：点击“只看电源层”，充电口位于画面上方，UPS主体在右侧，元器件朝上。USB金属右边缘至PCB右边缘11mm（实测）；金属壳宽8.94mm仍为参考值。PCB已按35.6×20.6×1.5mm更新；槽位36.2×21.2mm，每侧留0.3mm间隙。

点击“元件位置”对照UPS和ESP32的正面、接口及天线端。板上凸起为按照片绘制的元器件示意，可悬停查看名称。USB文字直接标在接口处；连线默认隐藏。元件示意不作尺寸或焊盘定位依据。

悬停查看元件 / 螺丝规格 · 拖动旋转 · 滚轮缩放
