krisxia0506/voxu/hardware/enclosure-battery/preview.html

# VOXU 分层装配

ESP32 卡扣转角修正版 8 · 62 × 46 × 31.4 mm
真实 CAD 网格 · 离线可用

拆解程度 0%

合拢完全拆解只看底座只看电源层元件位置连线标记：关螺丝孔位重置视角

显示零件

拖动旋转，滚轮缩放。拆解沿竖直方向展示层次，不代表实际拆装路径。电子件为外形包络；固定强度需打印试装确认。

底壳硬限位承受 USB 插拔；两片蓝色压片扣住 UPS 板边。右侧金色为 SS12D00G3，粉色为开关压盖。新增压件共用 4 枚 M2×4 平尾塑料自攻螺丝。

装配：先开关、UPS和压件，再装主板。拆卸外侧压片：卸螺丝后向侧壁退约 0.9 mm，再向上取出。外置开关接 SW/G 已由用户验证启停可用，详见接线演示。

金色十字头为12枚螺丝：UPS压片2、开关压盖2、托盘2、麦克风压框2（以上M2×4），上盖四角4（M2×8，可选加固）。托盘和麦克风螺丝从下向上安装。螺丝为简化外形，不含螺纹，不用于打印；头部按直径4mm、高1.5mm包络展示。

第8版：只重打底壳。ESP32四个卡扣内角增加R2圆弧，靠UPS一侧立柱接满横臂高度。清净圆弧下方支撑，轻拨扣唇装拆，实物强度待试装。

沿用第7版尺寸：点击“只看电源层”，充电口位于画面上方，UPS主体在右侧，元器件朝上。USB金属右边缘至PCB右边缘11mm（实测）；金属壳宽8.94mm仍为参考值。PCB已按35.6×20.6×1.5mm更新；槽位36.2×21.2mm，每侧留0.3mm间隙。

点击“元件位置”对照UPS和ESP32的正面、接口及天线端。板上凸起为按照片绘制的元器件示意，可悬停查看名称。USB文字直接标在接口处；连线默认隐藏。元件示意不作尺寸或焊盘定位依据。

悬停查看元件 / 螺丝规格 · 拖动旋转 · 滚轮缩放

## 接线演示 · 充电口外露，刷机口隐藏

当前为第7版硬固定底壳，已增加右侧独立开关座；用户已实测确认 SS12D00G3 接 SW/G 可以控制启停；下方新增外置开关接线详图。下面按板上丝印标记端点；元件位置是示意，不是焊盘比例图。红线为正极，灰线代表实际黑色负极线，蓝线为完整 USB 电缆。

当前为接线规划，尚未整机通电验收。电池充电兼容性未确认：550mAh 是容量，5V/1A 是 UPS 输出规格，均不能证明默认充电电流合适。可以先备线、焊接断电的板端；暂不要插电池和充电器。

日常电池供电UPS 口充电开盖刷机

总览① 断电准备② 黑线 / GND③ 红线 / VIN④ 电池接口⑤ 收线与复核⑥ 外置开关

虚线动画只表示选中连接，不能证明电流大小、切换无重启或边充边用已经实测。

### 外置开关 · SS12D00G3（用户实测启停可用）

中间脚 C 接 UPS 的 SW；任选一个外侧脚 A 接 UPS 的 G；另一外侧脚 B 不接并绝缘。不额外串电阻，也不串入电池或 5V 主电源线。A/B/C 是本图自定义名称，不是器件脚号；按中间与外侧辨认。

板载开关：保持你实测成功时的位置；尚未记录是 ON 还是 OFF，暂不指定档位。此次仅确认外置开关启停有效，不代表关闭后能隔离反向供电，刷机仍保留 J1 物理断开。

连接 | 起点 → 终点 | 操作要点
红线 / 正电源 | UPS OUT+ → J1 → ESP32 VIN | 按5V款规划；绝不接 ESP32 的3V3。
黑线 / 地 | UPS OUT− → J1 → ESP32 GND | 红黑两根一起可拔，不共用电池插头。
原电池线 | 红 → B+；黑 → B− | 优先原插头，核对极性；不要只看插头能否插入。未确认前不插。
充电 | USB 充电器 → UPS Type-C | 待充电电流与550mAh电池规格匹配后使用。
刷机 | 电脑数据线 → ESP32 USB-C | 先拔充电线、关UPS、拔开J1，再连电脑。结束后先拔电脑线，再恢复J1。

### 这次不需要焊的地方

USB 数据脚、CH340C 引脚、原板两端元件不做共口改造；UPS 的 IN+/IN− 留空，使用板载充电口；SW/G 按上方详图连接右侧独立开关。原麦克风接线保留，不在缺少针脚记录时重画它。

### 通电前仍缺的依据

UPS 默认充电电流与电池允许充电电流是否匹配；电池持续/峰值放电能力；此块 CH340C 开发板仅由 VIN 供电时的串口桥反向供电和启动表现。J1 能在刷机时物理分离 UPS 输出，但不能替代这些确认。

参考：Espressif 官方开发板供电方式互斥说明 (https://docs.espressif.com/projects/esp-dev-kits/en/latest/esp32/esp32-devkitc/user_guide.html)。这是设计原则参考，并不是你这块 CH340C 克隆板的原理图。
