krisxia0506/voxu/hardware/enclosure-battery/layout.png

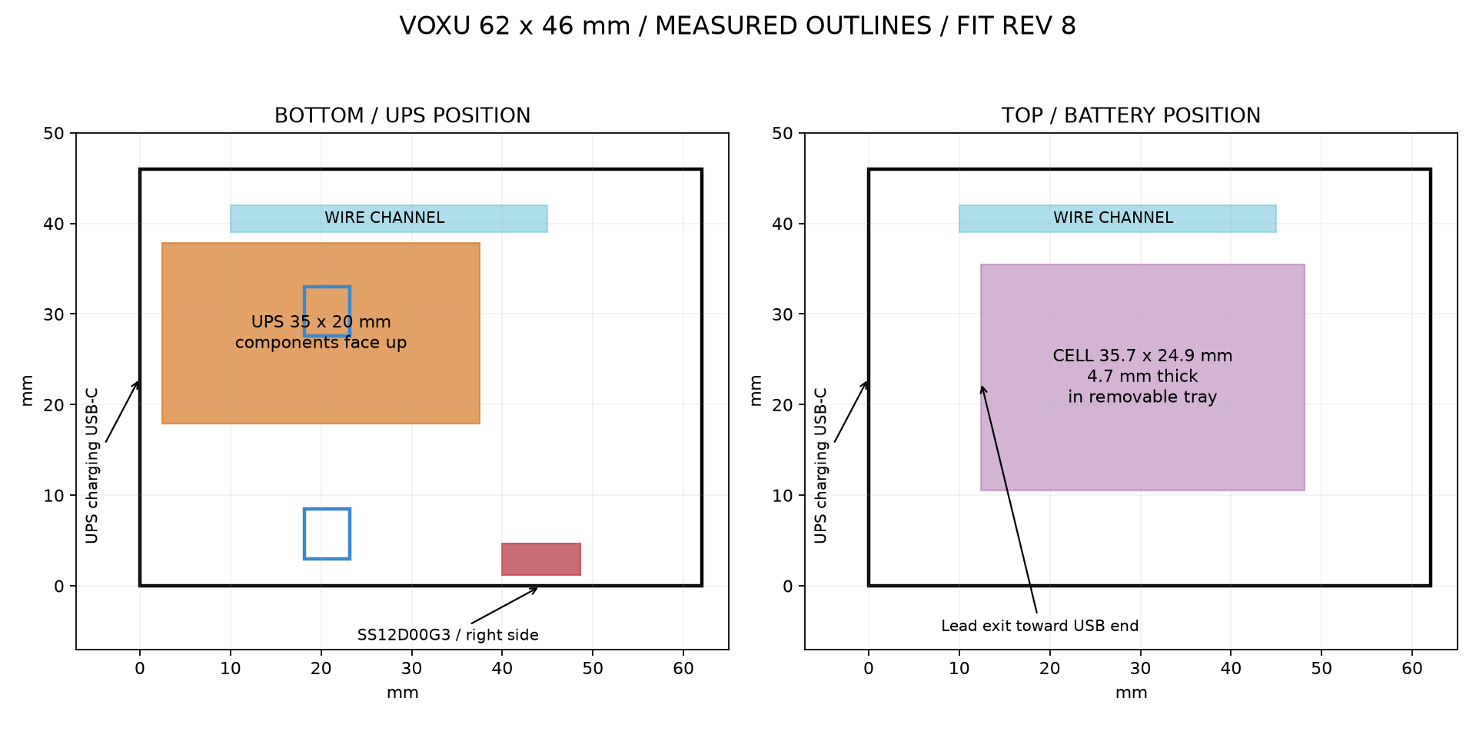
hardware/enclosure-battery/layout.png
