krisxia0506/voxu/hardware/integrated-pcba/lceda-pro/previews/compact-pdm-3d.png

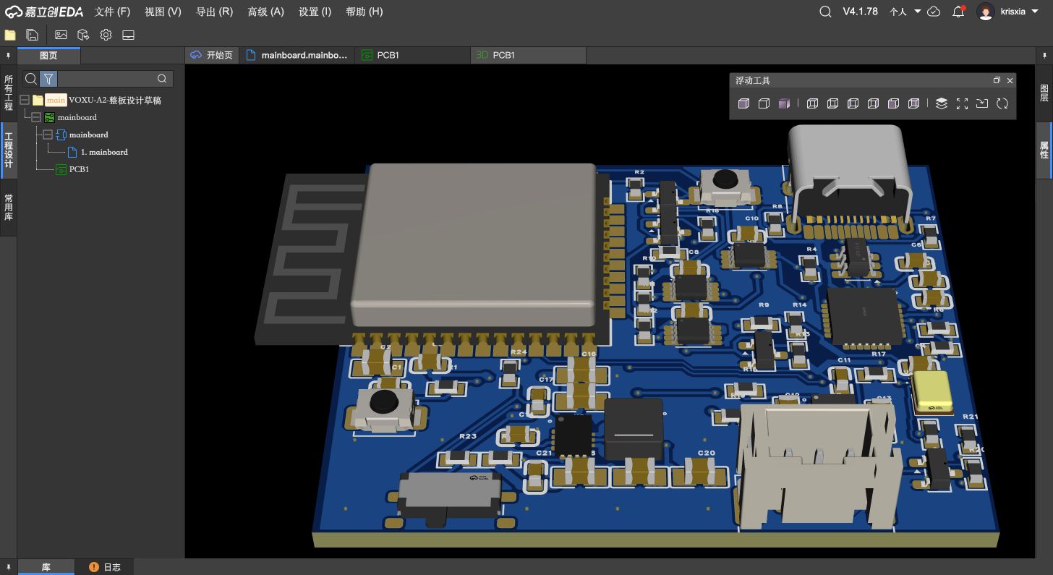
hardware/integrated-pcba/lceda-pro/previews/compact-pdm-3d.png
