krisxia0506/voxu/hardware/integrated-pcba/lceda-pro/previews/compact-pdm-drc.png

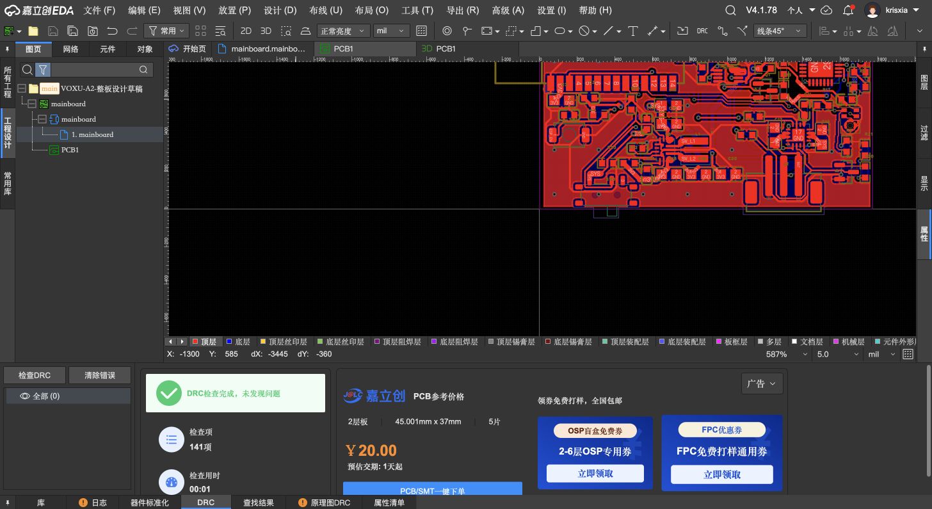
hardware/integrated-pcba/lceda-pro/previews/compact-pdm-drc.png
