krisxia0506/voxu/hardware/integrated-pcba/lceda-pro/previews/compact-pdm-hole060-drc.png

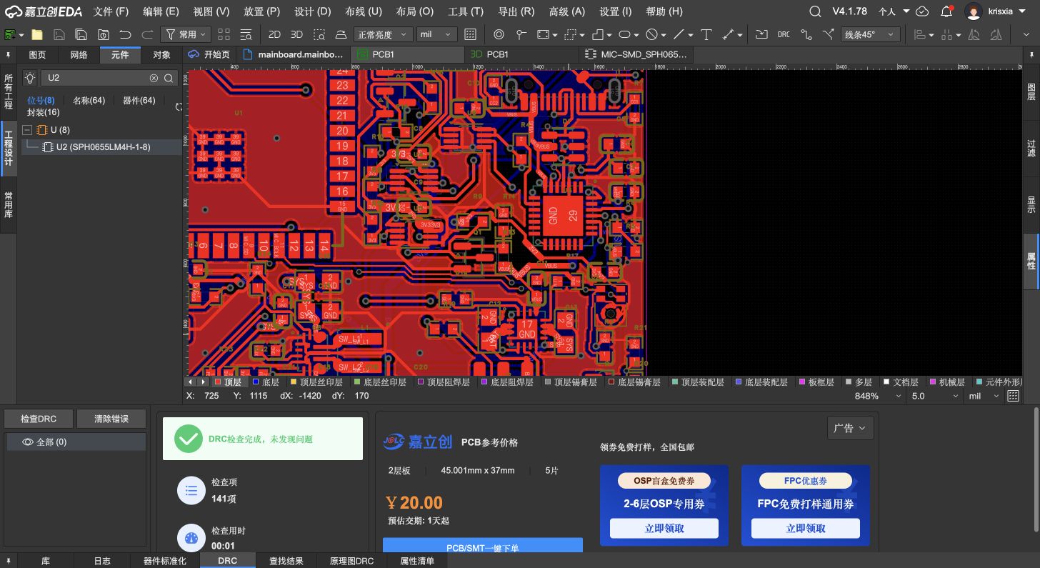
hardware/integrated-pcba/lceda-pro/previews/compact-pdm-hole060-drc.png
