krisxia0506/voxu/hardware/integrated-pcba/lceda-pro/previews/compact-pdm-layout.png

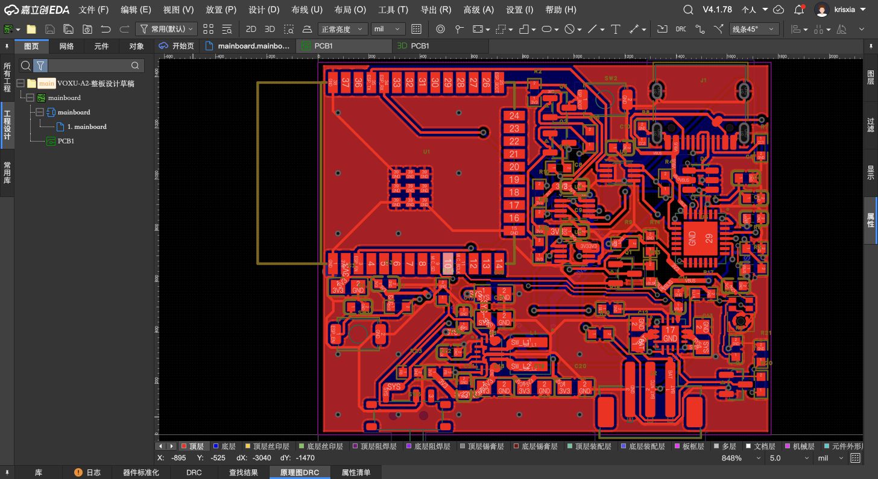
hardware/integrated-pcba/lceda-pro/previews/compact-pdm-layout.png
