krisxia0506/voxu/hardware/integrated-pcba/lceda-pro/previews/compact-pdm-pcb-quote.png

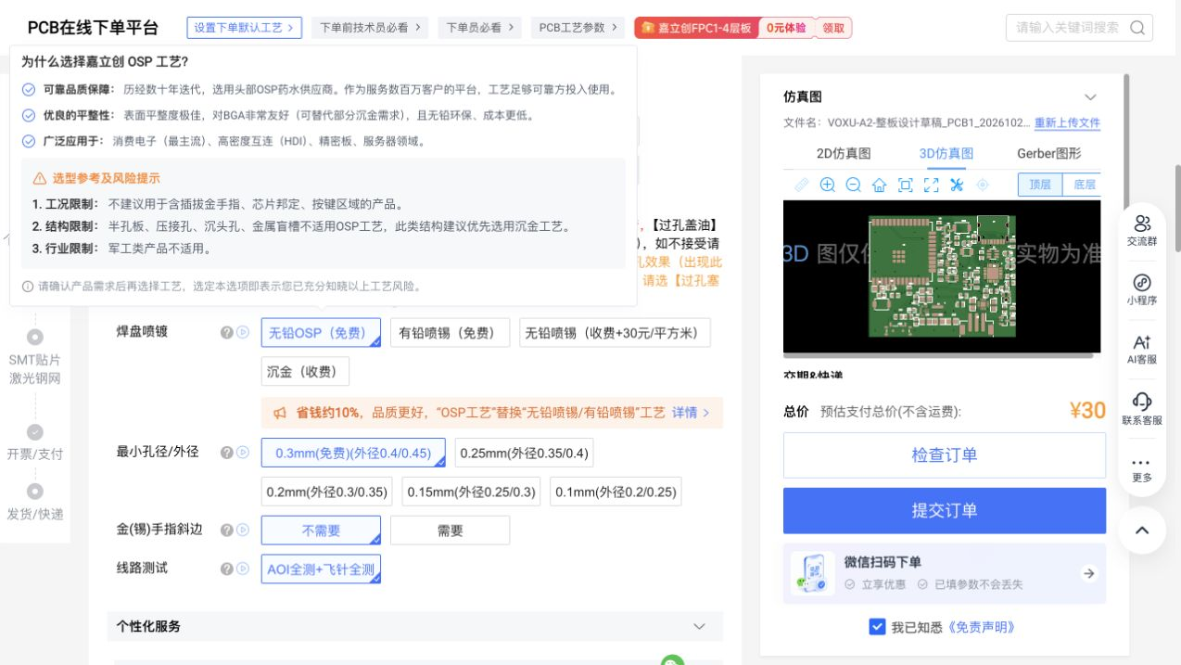
hardware/integrated-pcba/lceda-pro/previews/compact-pdm-pcb-quote.png
