krisxia0506/voxu/hardware/integrated-pcba/lceda-pro/previews/compact-switch-locators-drc.png

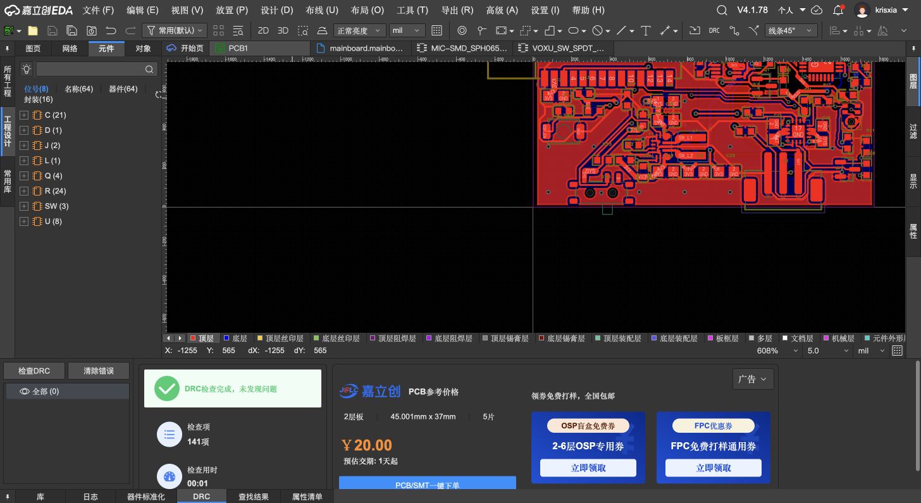
hardware/integrated-pcba/lceda-pro/previews/compact-switch-locators-drc.png
