krisxia0506/voxu/hardware/integrated-pcba/lceda-pro/previews/short-edge-drc.png

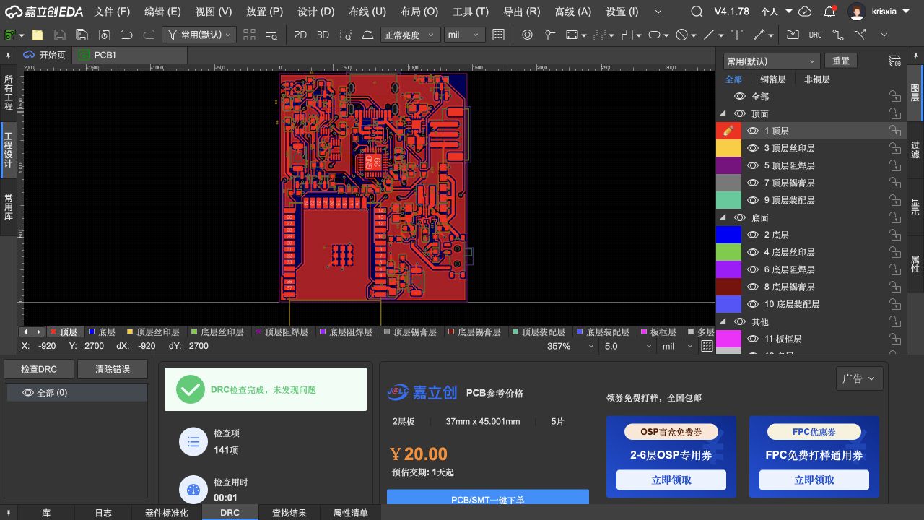
hardware/integrated-pcba/lceda-pro/previews/short-edge-drc.png
