krisxia0506/voxu/hardware/integrated-pcba/lceda-pro/previews/voxu-3d-board.png

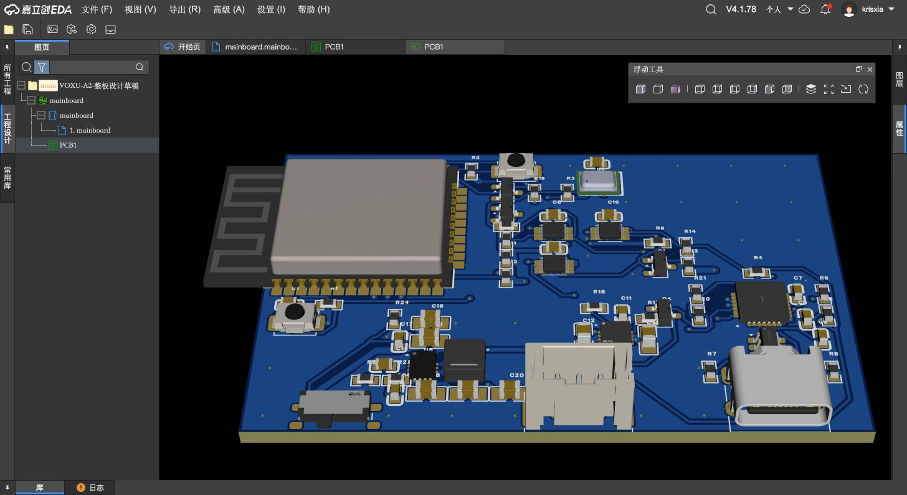
hardware/integrated-pcba/lceda-pro/previews/voxu-3d-board.png
