krisxia0506/voxu/hardware/integrated-pcba/lceda-pro/previews/voxu-compact-drc.png

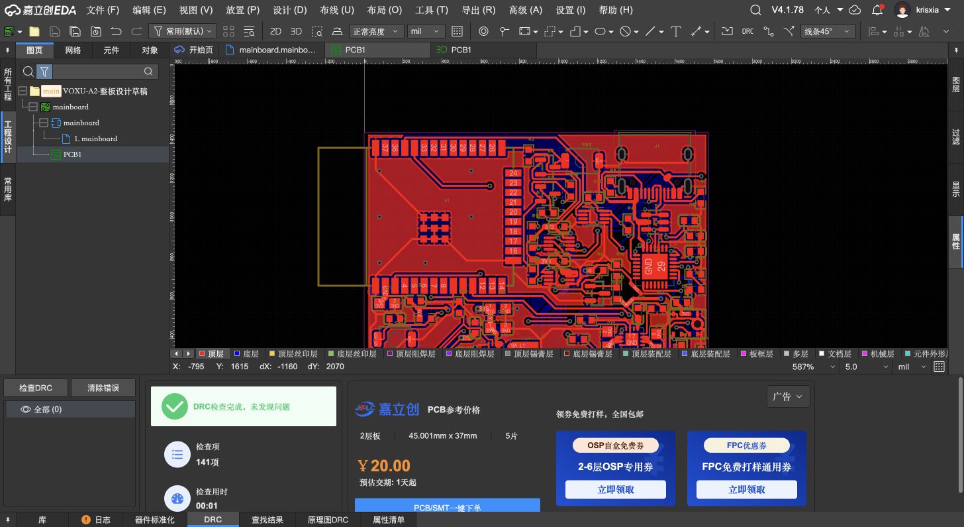
hardware/integrated-pcba/lceda-pro/previews/voxu-compact-drc.png
