krisxia0506/voxu/hardware/integrated-pcba/lceda-pro/previews/voxu-compact-pcb.png

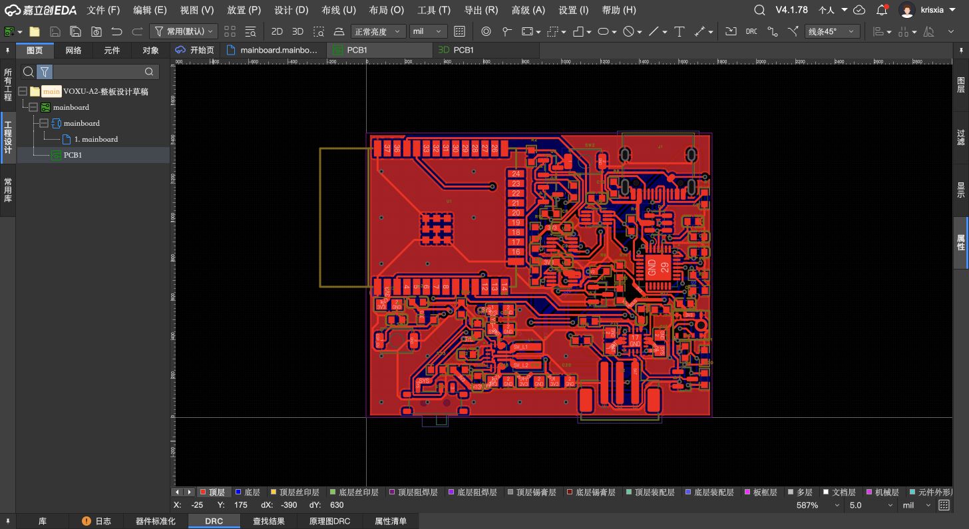
hardware/integrated-pcba/lceda-pro/previews/voxu-compact-pcb.png
