krisxia0506/voxu/hardware/integrated-pcba/lceda-pro/previews/voxu-drc.png

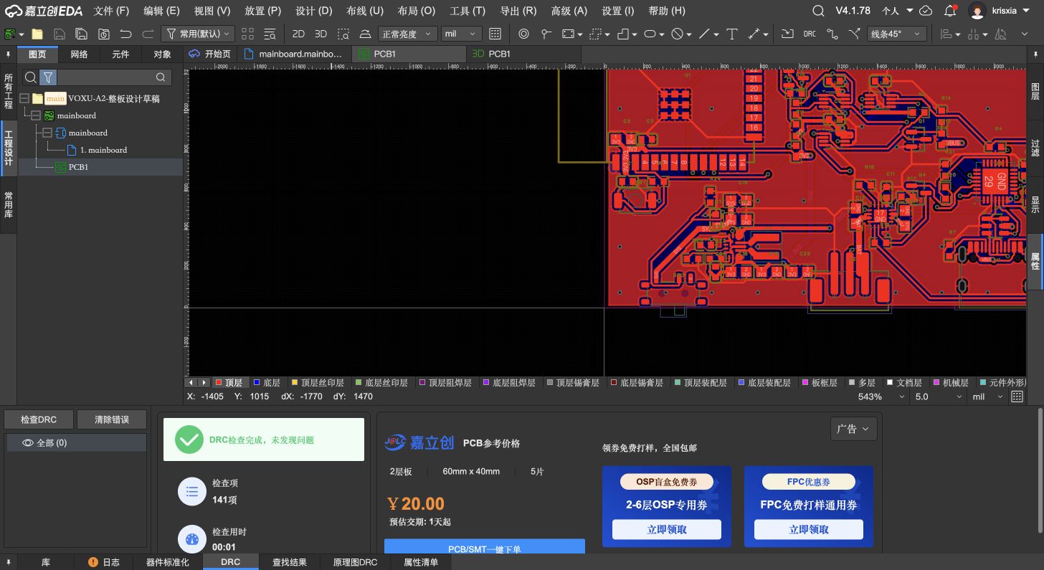
hardware/integrated-pcba/lceda-pro/previews/voxu-drc.png
