krisxia0506/voxu/hardware/integrated-pcba/lceda-pro/previews/voxu-pcb-routed.png

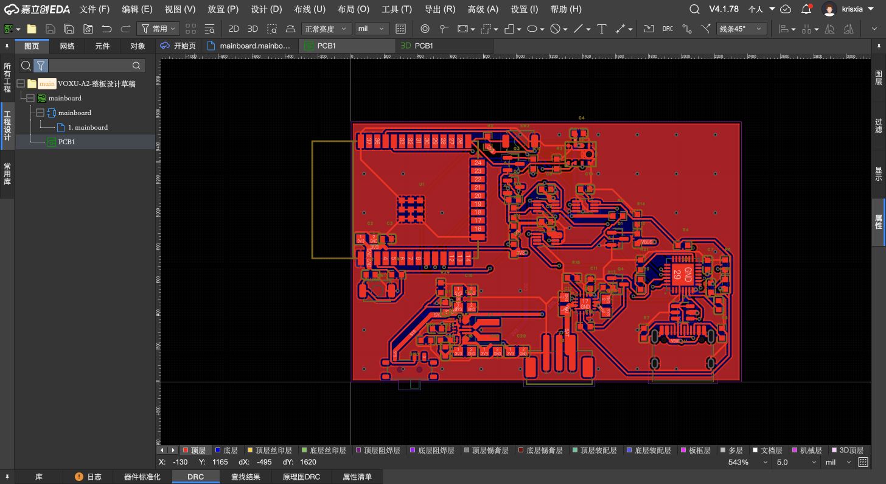
hardware/integrated-pcba/lceda-pro/previews/voxu-pcb-routed.png
