krisxia0506/voxu/renders/voice-puck-form-d-hexagonal.png

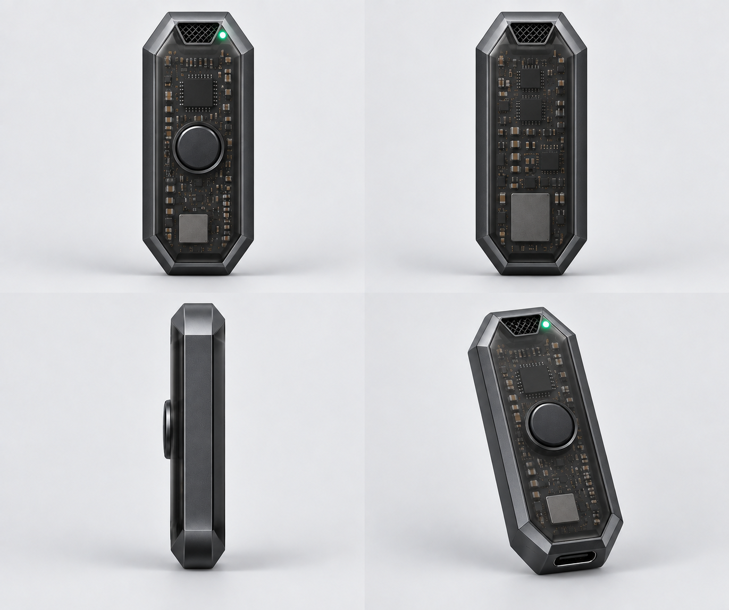
renders/voice-puck-form-d-hexagonal.png
