krisxia0506/voxu/renders/voice-puck-form-f-slim-bar.png

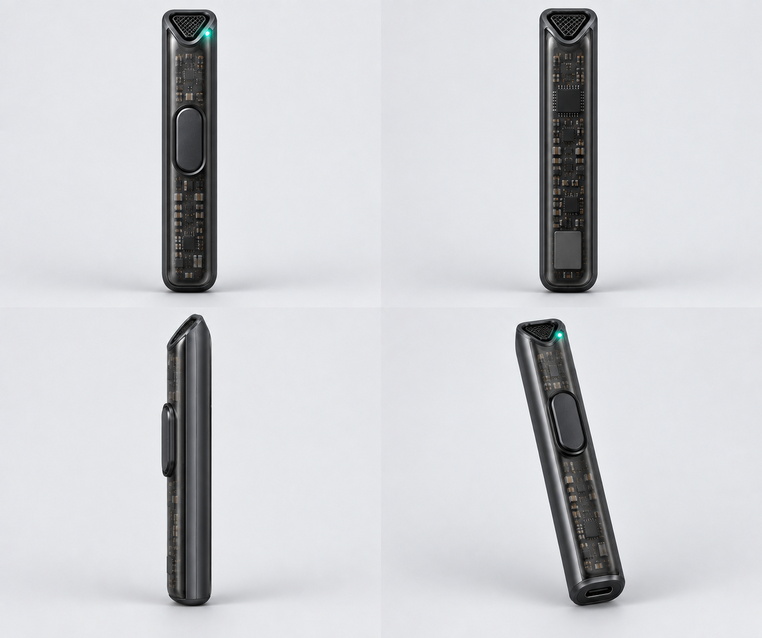
renders/voice-puck-form-f-slim-bar.png
