krisxia0506/voxu/renders/voice-puck-redesign-g-ceramic-lozenge.png

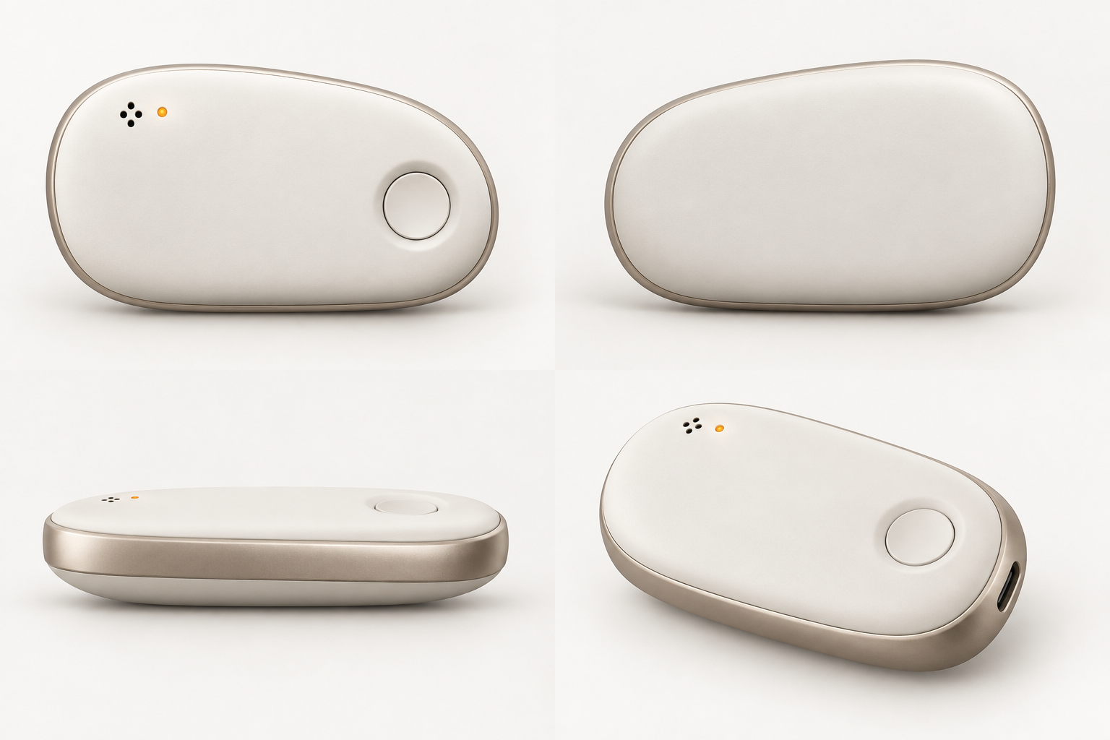
renders/voice-puck-redesign-g-ceramic-lozenge.png
