krisxia0506/voxu/renders/voice-puck-redesign-h-micro-module.png

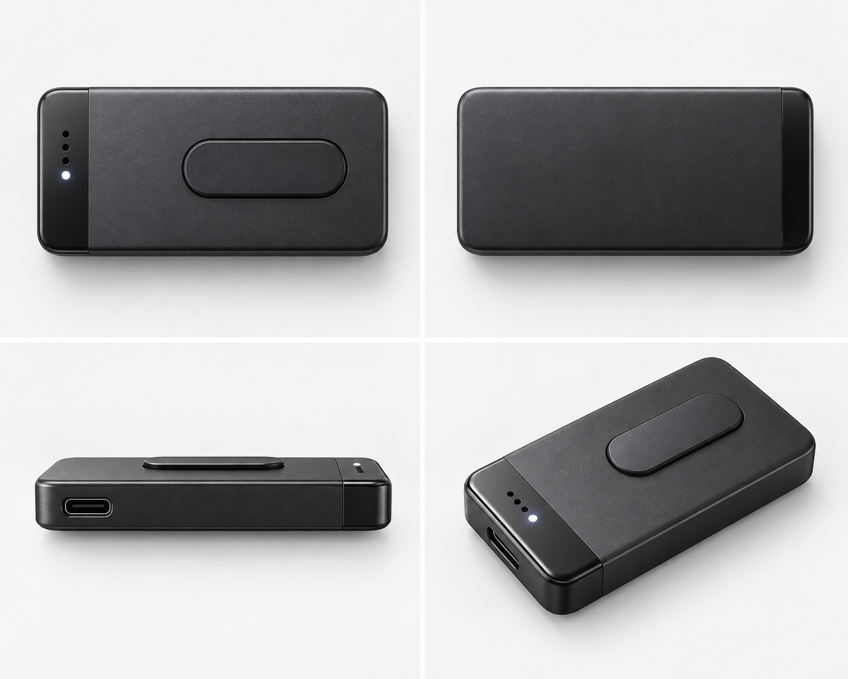
renders/voice-puck-redesign-h-micro-module.png
