krisxia0506/voxu/renders/voice-puck-redesign-i-square-tile.png

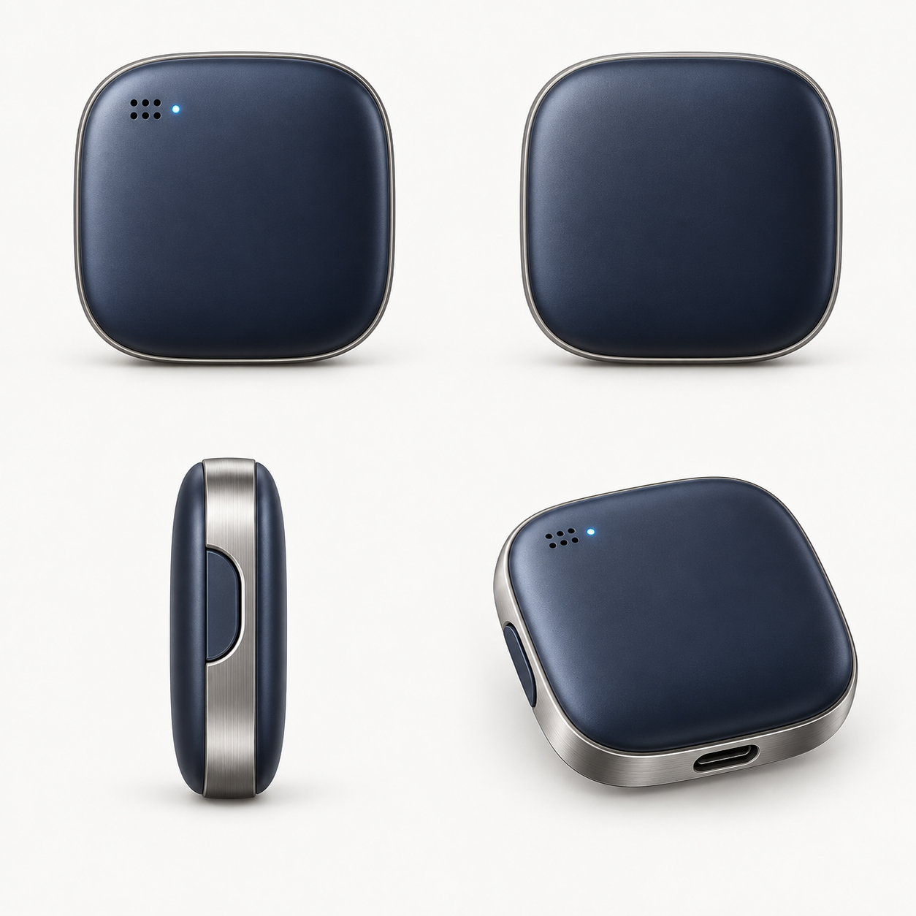
renders/voice-puck-redesign-i-square-tile.png
