krisxia0506/voxu/renders/voice-puck-redesign-j-exoskeleton.png

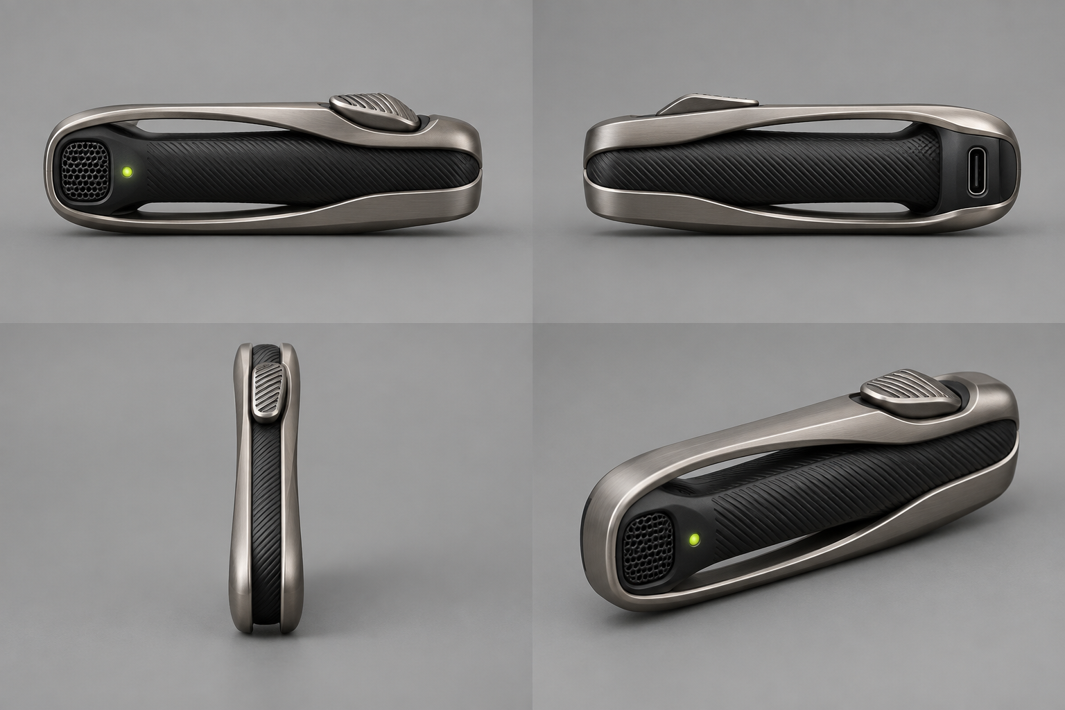
renders/voice-puck-redesign-j-exoskeleton.png
