krisxia0506/voxu/renders/voice-puck-redesign-k-shutter.png

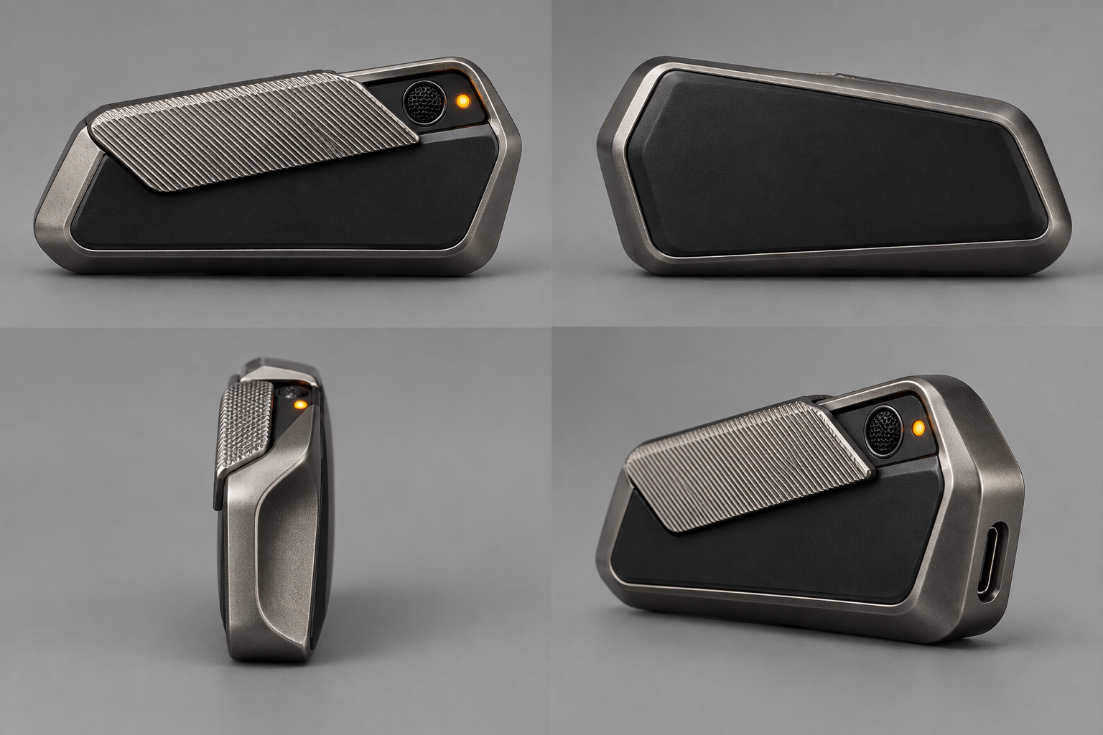
renders/voice-puck-redesign-k-shutter.png
