krisxia0506/voxu/renders/voice-puck-redesign-l-sculpted-grip.png

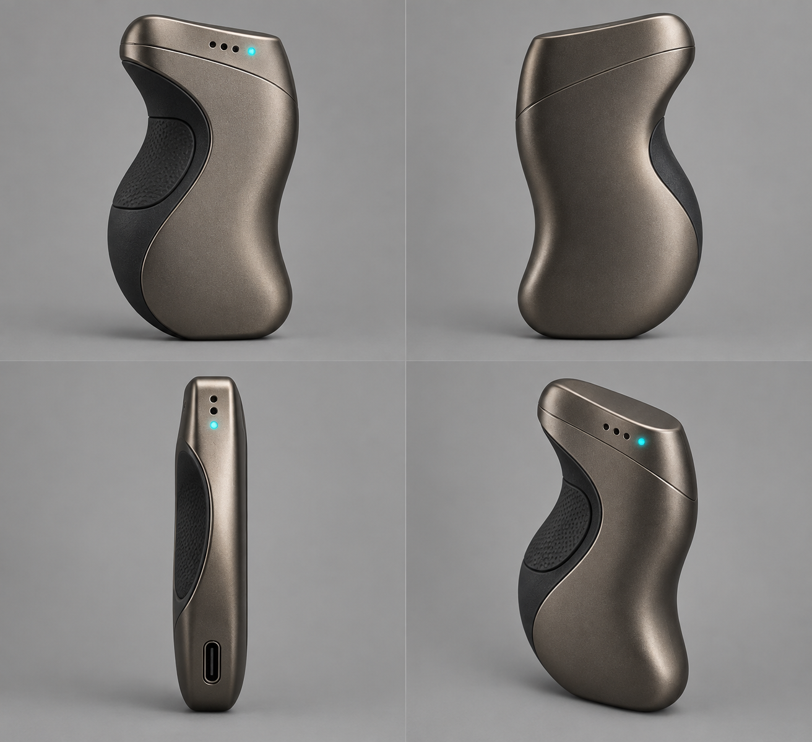
renders/voice-puck-redesign-l-sculpted-grip.png
