krisxia0506/voxu/renders/voice-puck-v1-concept.png

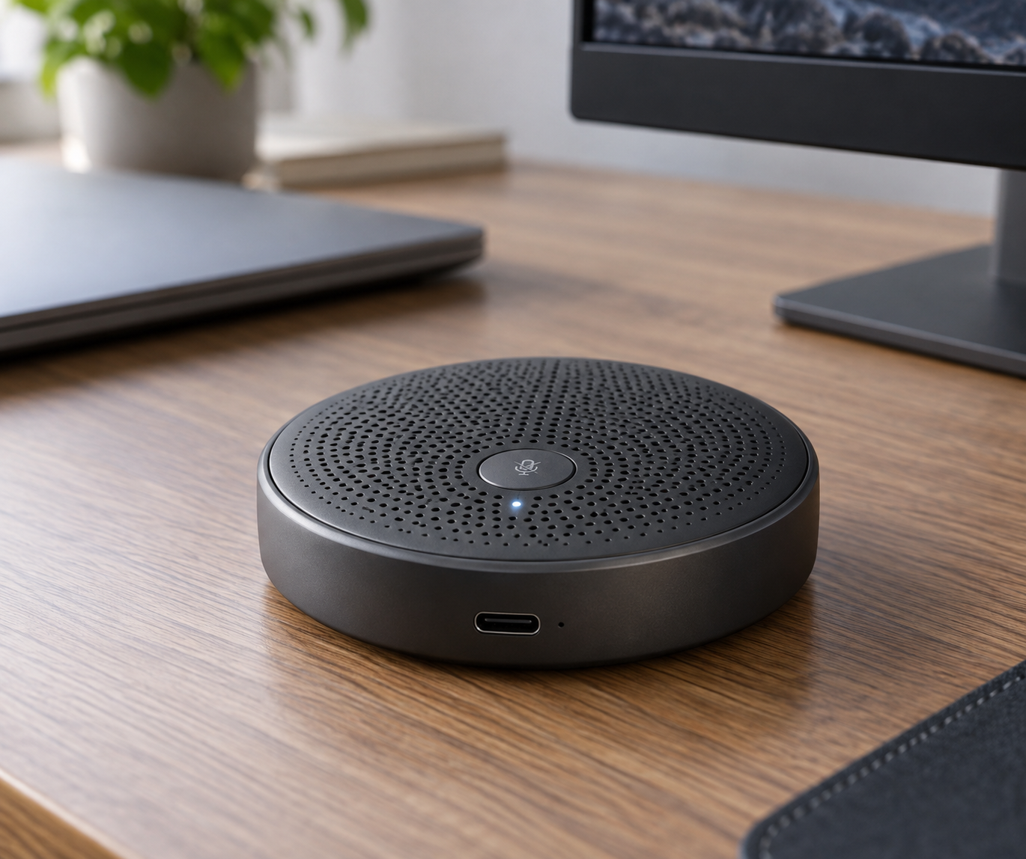
renders/voice-puck-v1-concept.png
