krisxia0506/voxu/renders/voice-puck-v1-handheld-concept-v2.png

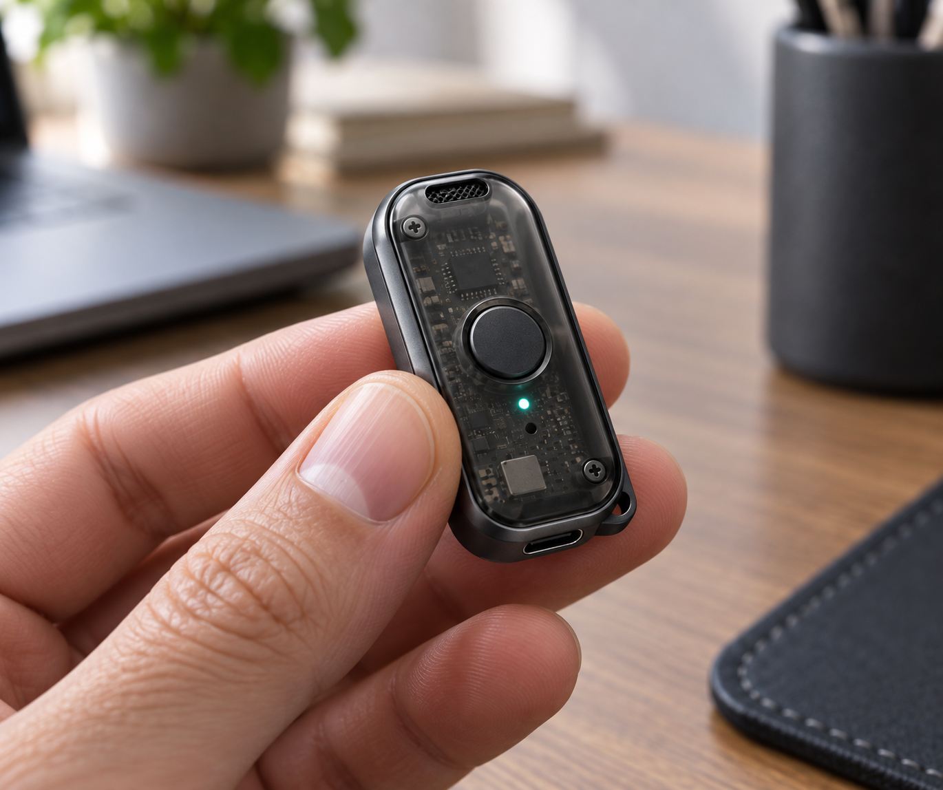
renders/voice-puck-v1-handheld-concept-v2.png
