krisxia0506/voxu/BOM.md

# Voice Puck V1 BOM

更新日期：2026-09-29。目标是用原版 ESP32、I²S 数字麦克风和 Bluetooth Classic HFP，做出可在 Mac 的 Typeless 中使用的无线麦克风。本文是原型采购与验证清单；数量按一台原型计算，不代表量产定版。V1 外观方向已选定为 [M：双层护脊壳](renders/voice-puck-printable-m-ribbed-shell.png)，可打印 CAD 与内部尺寸仍待设计。

## 当前物料状态

| 物料 | 目标数量 | 当前状态 | 说明 |
| --- | ---: | --- | --- |
| 原版 ESP32 开发板 | 1 块 | **已接入并确认芯片** | 串口读取到 `ESP32-D0WD-V3`，支持 Bluetooth Classic。开发板具体型号、板载接口和供电电路尚未确认。 |
| 开发板数据线 | 1 根 | **已具备** | 当前已能通过 USB 串口连接；具体接口类型以实物为准。 |
| INMP441 I²S 麦克风模块 | 1 个，建议另备 1 个 | **已到手** | 实物引脚丝印尚待核对；接线见 [WIRING.md](WIRING.md)。 |
| 面包板与杜邦线 | 各 1 套 | 待确认 | 麦克风接入时使用；线尽量短。 |

**现在可做：**先按 [WIRING.md](WIRING.md) 接入 INMP441，分别验证 I²S 采音和 HFP 音频链路，再测试 Mac 录音与 Typeless 听写。能够配对不等于音频链路已经打通。

## 阶段 A：USB 供电功能原型

| 物料 | 数量 | 优先级 | 用途或选型条件 |
| --- | ---: | --- | --- |
| 原版 ESP32 开发板 | 1 | 已具备 | 使用现有板；固件目标按实测芯片 `ESP32-D0WD-V3` 配置。 |
| INMP441 I²S 麦克风模块 | 1，备件 1 | **已具备 1 个** | 单麦先验证音频链路；模块供电、电平与引脚按实物丝印和芯片数据手册核对。 |
| 面包板、杜邦线 | 各 1 套 | 缺少时采购 | 临时接线；稳定后再考虑焊接。 |
| 万用表 | 1 | 建议 | 接线前检查电源电压、极性和短路。 |
| 已知能作为 Mac 输入的蓝牙耳机 | 1 副 | 已有则复用 | 作为 Mac 与 Typeless 使用场景的对照，不属于成品。 |

**阶段 A 通过条件：**Mac 系统输入中出现自制设备；录音工具和 Typeless 都能获得可辨认语音；记录实际 HFP 编码协商结果、断线重连与合盖外接屏表现。未通过前不采购定制 PCB 或批量物料。

## 阶段 B：电池桌面原型

在阶段 A 通过、并测得录音和待机电流后再定电池容量及具体电源板。

| 物料 | 数量 | 当前状态 | 用途或选型条件 |
| --- | ---: | --- | --- |
| 轻触按键 | 2 个 | 待采购 | 配对与静音；也可先用一个按键验证交互。 |
| 状态 LED、匹配的限流电阻 | 2 组 | 待采购 | 连接和静音状态；具体阻值按 LED 与供电设计计算。 |
| 单节锂电池 | 1 个 | 暂缓选型 | 选带保护的电池，容量按实测电流和续航目标确定；核对连接器极性。 |
| USB-C 单节锂电充电及电源路径模块 | 1 个 | 暂缓选型 | 如需边充边用，选明确支持 Power Path 的方案，例如 BQ24074 类模块；确认充电电流与电池匹配。 |
| 3.3 V 稳压电源模块 | 1 个 | 暂缓选型 | 输出电流须覆盖 ESP32 峰值负载；充电模块输出不能未经稳压和核对就接到 3V3 引脚。 |
| 电源开关、连接器与短线 | 各 1 套 | 待采购 | 按最终电源连接方式确定。 |
| 简易外壳、麦克风固定件 | 1 套 | 外观方向已定，尺寸待测 | 以 M 双层护脊壳为造型基准；拾音孔、固定方式和内部空间以实物测量和录音测试确定。 |
| 电流测量工具 | 1 | 已有则复用 | 测录音、空闲、重连和充电状态电流。 |

开发板的 USB、5V 和 3V3 供电路径需按**实物原理图**确认，不应同时接入互相冲突的电源。当前只确认了芯片型号，不能据此假定开发板就是某一款 DevKitC。

## 不列入 V1 必购

- LE Audio 开发板：属于后续兼容性研究。
- 第二颗或阵列麦克风：单麦拾音效果实测后再决定。
- HID 专用器件：快捷键属于可选增强，先验证音频功能。
- 定制 PCB、量产外壳：在 Mac 端链路和电源数据确认后设计。
- 扬声器或音频功放：纯麦克风形态的 HFP 互操作性先实测；只有调试或兼容性需要时再补。

## 选型参考

- [乐鑫 ESP32 芯片蓝牙能力](https://docs.espressif.com/projects/esp-idf/en/latest/esp32/api-guides/bt-architecture/overview.html)
- [乐鑫 HFP HF API 与示例](https://docs.espressif.com/projects/esp-idf/en/stable/esp32/api-reference/bluetooth/esp_hf_client.html)
- [TDK INMP441 数据手册](https://invensense.tdk.com/wp-content/uploads/2015/02/INMP441.pdf)
- [TI BQ24074 充电与 Power Path 资料](https://www.ti.com/product/BQ24074)

采购前应再次核对模块引脚、供电电压、接口形式、连接器极性和实际供货情况。
