krisxia0506/voxu/hardware/enclosure-battery/V2-BOM.md

# VOXU V2：电池版与 BOM

记录日期：2026-10-18。用户指定本次产品版本为 **V2**。

V2 采用原 ESP32 开发板、原麦克风、常规款 5V UPS 充电升压一体板和 3.7V / 550mAh 电池。此版本号指 VOXU 产品方案，不是电源板上的 `V1.0` 硬件丝印，也不表示整机已经完成电气验收。外壳正在按到货实物适配；本记录不冻结尚在修改的 CAD 尺寸或覆盖生成文件。

## 版本要求

- 保留原开发板 USB-C 作为外部接口，目标为电脑连接时充电并可刷机、充电器连接时充电，拔线后自动由电池供电，无需切换供电模式。
- 支持边充边用；运行开关关闭后继续充电为待核实要求。
- 优先完成可用产品；外壳长宽或厚度允许适当调整，约 1cm 的增减可接受，不再受原 60 × 40mm 长宽硬限制。
- 依照商品说明推进设计，用户不要求在外壳设计前实测输出电压。未实测的性能不记录为已验证。

## 核心材料（每台用量）

| 项目 | V2 规格／选择 | 每台数量 | 来源与状态 |
| --- | --- | --- | --- |
| 主控开发板 | ESP32-WROOM-32，30 针，CH340C 串口桥，板载 USB-C；沿用现有板 | 1 块 | 已有；型号依据实物照片及用户确认 |
| 麦克风模块 | 原圆形 INMP441 模块，参考直径 14mm | 1 块 | 沿用原机，未重新采购 |
| 充电升压一体板 | 单片机 UPS，**常规款-5V**，板载开关和电池插座；商品标称 5V / 1A，实物版本 V1.0 | 1 块 | 已到货；[创客工厂商品](https://mobile.yangkeduo.com/goods.html?goods_id=904887107922) |
| 锂聚合物电池 | **3.7V / 550mAh**，红黑引线及插头；原选带保护板款 | 1 块 | 已到货；550mAh 依用户对购买实物的明确说明；[电池商品](https://mobile.yangkeduo.com/goods.html?goods_id=580421104652) |
| 电源线 | 26 AWG 红黑双并多股硅胶线，商品标注 0.15mm² | 按实际走线裁剪 | [高温电线电缆制造商](https://mobile.yangkeduo.com/goods.html?goods_id=1011445963655)，原选规格为 5m 一包，不是每台用量 |
| 信号／控制线 | 用户已有 30 AWG 单芯 OK 线 | 按实际走线裁剪 | 不重复购买；不作为电池主电源线的默认替代 |
| 绝缘胶带 | PI 聚酰亚胺胶带，10mm 宽 | 按需 | [YXW 官方旗舰店](https://mobile.yangkeduo.com/goods.html?goods_id=399430343617)，原选 30码长 × 2卷 |
| 热缩管 | 内径 2.0mm，2:1 收缩 | 按焊点数量裁剪 | [华贸电子线材](https://mobile.yangkeduo.com/goods.html?goods_id=479117644582)，原选 10m 一包 |
| 托盘固定螺钉 | M2 × 4，十字圆头平尾塑料自攻用途螺钉；商品头径 3.4mm、头高 1.2mm | 按最终 CAD 紧固点数量；旧样件为 2 颗 | [YINGYUE 紧固店](https://mobile.yangkeduo.com/goods.html?goods_id=306539121239)，原选 500颗一包 |

用户已说明本次购买的零部件均已到货；照片直接核对到的新增核心件为一体电源板与电池。其余配件规格依据此前选购记录，未逐件核验包装标签。

## 实物尺寸基线

以下读数取自用户 2026-10-18 提供的卡尺照片，单位 mm。尺寸为读数记录，不代表整个安装空间已经包含接线、插头、USB 外伸和装配余量。

| 零件 | 长 | 宽 | 厚／测量高度 | 依据 |
| --- | ---: | ---: | ---: | --- |
| 一体电源板 | 35.6 | 20.6 | 5.6 | 2026-10-19重新实测长宽；PCB厚1.5mm，总高沿用原测量 |
| 电池（含照片所示封装） | 35.7 | 24.9 | 4.7 | IMG_6662、IMG_6661、IMG_6663 |

外壳需另留绝缘、走线、插头和软包电池非挤压余量。电源板 USB-C、开关与电池出线口的位置按实物照片布置；最终打印尺寸以本目录生成结果为准，不把商品的 5mm 厚度替代实测 5.6mm。

## 打印件与可选配件

| 项目 | 数量／用途 | 状态 |
| --- | --- | --- |
| 外壳底座、上盖 | 各 1 件 | V2 按实物重新适配 |
| BOOT 按帽、顶杆 | 各 1 件 | 沿用功能，几何长度随新外壳调整 |
| 电池托盘 | 1 件 | 按 550mAh 实物尺寸适配 |
| 麦克风压框 | 0–1 件 | 可选，以实际卡装情况决定 |
| 一体板支撑／固定件、开关操作件 | 按最终 CAD | 不预先承诺沿用旧样件结构或数量 |
| SS12D00G3 三脚两档拨动开关 | 1 只，已购 | [跃一电子](https://mobile.yangkeduo.com/goods.html?goods_id=702019867703)，已选柄高 G3、5只装；第5版已设计右侧安装座；柄高3mm，本体8.6×3.6×3.5mm；中间脚接 SW、一个外侧脚接 G，用户已验证启停可用 |
| 电池配套插头线 | 非必需 | 实物电池已有插头；匹配型号、针距及极性未确认。也可使用电池自带引线接 B+／B− 焊盘，无需另购板端插座 |
| 四角 M2 × 8 加固螺钉 | 如最终外壳保留，可选 4 颗 | 不是本次已确认采购项 |

打印件、紧固件最终数量与 STL 清单保持一致；本 BOM 不将正在设计的零件误记为已经打印或试装通过。

## V2 不再采用的独立模块

- **MCP73871 独立充电板**：由一体板替代，不与一体板重复串接。
- **TPS61023 独立升压板**：由一体板替代。
- **PowerBoost 1000C**：早期布局参考，不是此次到货材料。
- **新增 30 AWG OK 线套装**：用户已有，无需重复购买。

上述“不再采用”是 V2 BOM 选择，不表示已经代用户退货或删除所有对应收藏。

## 电气状态与尚未确认的规格

- 5V / 1A 是商品的**输出**规格，不是电池充电电流。
- 电源板背面印有 `Ichg = 300 / Iset` 及 `800mA`。此前将 300 解释为默认 300mA 的说法作废。V2 不以该误读作为电池适配依据；默认充电电流与实物电阻、芯片资料的对应仍待核实，暂按可能为 800mA 处理。
- 550mAh 电池的允许充电电流、持续／峰值放电电流仍没有明确规格证据；不能由容量或带保护板推定。早期商品候选曾为 500mAh，本版本以用户确认的 **550mAh** 为准。
- 最新方案为 UPS 口充电、原 ESP32 USB-C 隐藏用于刷机；输出线增加内部两芯可拔接头 J1（具体型号与装配位置待确认），刷机前物理断开 UPS 输出。见 wiring.md 和网页接线演示。VIN 单独供电下的 CH340C 行为仍待确认。
- USB／电池切换、关机充电、低负载持续输出、热表现和续航尚未整机验证。不承诺 4–6 小时续航。

以上电气待确认项不阻止按实物尺寸设计和打印机械试装件，但不能据此宣称整机可以直接通电使用。

第5版新增打印件：UPS 左/右压片、开关压盖。另用 **4枚 M2×4 平尾塑料自攻螺丝**（不占用电池托盘原有2枚）；头径不大于4mm、头高不大于1.5mm。UPS 不再用胶带承力。
