krisxia0506/voxu/hardware/integrated-pcba/economy-e1/bom-candidate.csv

Designator | Comment | Footprint | LCSC Part #
U1 | ESP32-PICO-V3 |  | C967022
R1 | 10k 1% | Resistor_SMD:R_0603_1608Metric | C25804
R2 | 10k 1% | Resistor_SMD:R_0603_1608Metric | C25804
C1 | 1u 50V X5R | Capacitor_SMD:C_0603_1608Metric | C15849
C2 | 10u 10V X5R | Capacitor_SMD:C_0805_2012Metric | C15850
C3 | 100n 10V X7R | Capacitor_SMD:C_0603_1608Metric | C14663
SW1 | RESET push button |  | C720477
SW2 | DICTATE / BOOT push button |  | C720477
U2 | SPH0655LM4H-1-8 | MIC-SMD_SPH0655LM4H-1-8 | C22376158
R3 | 100k 1% | Resistor_SMD:R_0603_1608Metric | C25803
C4 | 100n 10V X7R | Capacitor_SMD:C_0603_1608Metric | C14663
U3 | CP2102N-A02-GQFN28 | VOXU:VOXU_CP2102N_QFN28 | C964632
R4 | 10k 1% | Resistor_SMD:R_0603_1608Metric | C25804
R5 | 2.2k 1% | Resistor_SMD:R_0603_1608Metric | C4190
R6 | 10k 1% | Resistor_SMD:R_0603_1608Metric | C25804
C5 | 4.7u 10V X5R | Capacitor_SMD:C_0603_1608Metric | C19666
C6 | 100n 10V X7R | Capacitor_SMD:C_0603_1608Metric | C14663
C7 | 100n 10V X7R | Capacitor_SMD:C_0603_1608Metric | C14663
R7 | 5.1k 1% | Resistor_SMD:R_0603_1608Metric | C23186
R8 | 5.1k 1% | Resistor_SMD:R_0603_1608Metric | C23186
J1 | USB-C USB2 receptacle |  | C165948
D1 | USBLC6-2SC6 | Package_TO_SOT_SMD:SOT-23-6 | C7519
U4 | SN74LVC2G125DCUR | Package_SO:VSSOP-8_2.3x2mm_P0.5mm | C21404
U5 | SN74LVC2G125DCUR | Package_SO:VSSOP-8_2.3x2mm_P0.5mm | C21404
U6 | SN74LVC2G125DCUR | Package_SO:VSSOP-8_2.3x2mm_P0.5mm | C21404
C8 | 100n 10V X7R | Capacitor_SMD:C_0603_1608Metric | C14663
C9 | 100n 10V X7R | Capacitor_SMD:C_0603_1608Metric | C14663
C10 | 100n 10V X7R | Capacitor_SMD:C_0603_1608Metric | C14663
R9 | 10k 1% | Resistor_SMD:R_0603_1608Metric | C25804
R10 | 10k 1% | Resistor_SMD:R_0603_1608Metric | C25804
R11 | 10k 1% | Resistor_SMD:R_0603_1608Metric | C25804
R12 | 10k 1% | Resistor_SMD:R_0603_1608Metric | C25804
R13 | 10k 1% | Resistor_SMD:R_0603_1608Metric | C25804
R14 | 100k 1% | Resistor_SMD:R_0603_1608Metric | C25803
Q1 | MMBT3904 | Package_TO_SOT_SMD:SOT-23 | C20526
R15 | 10k 1% | Resistor_SMD:R_0603_1608Metric | C25804
R16 | 10k 1% | Resistor_SMD:R_0603_1608Metric | C25804
Q2 | MMBT3904 | Package_TO_SOT_SMD:SOT-23 | C20526
Q3 | MMBT3904 | Package_TO_SOT_SMD:SOT-23 | C20526
U7 | BQ24075RGTR | VOXU:VOXU_BQ24075_RGT0016C | C15464
R17 | 3.9k 1% | Resistor_SMD:R_0603_1608Metric | C23018
R18 | 8.2k 1% | Resistor_SMD:R_0603_1608Metric | C25981
R19 | 10k 1% | Resistor_SMD:R_0603_1608Metric | C25804
R20 | 10k 1% | Resistor_SMD:R_0603_1608Metric | C25804
R21 | 10k 1% | Resistor_SMD:R_0603_1608Metric | C25804
Q4 | MMBT3904 | Package_TO_SOT_SMD:SOT-23 | C20526
C11 | 4.7u 10V X5R | Capacitor_SMD:C_0603_1608Metric | C19666
C12 | 10u 10V X5R | Capacitor_SMD:C_0805_2012Metric | C15850
C13 | 10u 10V X5R | Capacitor_SMD:C_0805_2012Metric | C15850
J2 | 1S protected battery + 10k NTC |  | C160353
U8 | TPS63070RNMR |  | C109322
L1 | SMS0420-1R5MT 1.5uH |  | C5127348
R22 | 470k 1% | Resistor_SMD:R_0603_1608Metric | C23178
R23 | 150k 1% | Resistor_SMD:R_0603_1608Metric | C22807
R24 | 100k 1% | Resistor_SMD:R_0603_1608Metric | C25803
SW3 | RUN SPDT slide |  | C431540
C14 | 100n 10V X7R | Capacitor_SMD:C_0603_1608Metric | C14663
C15 | 10u 25V X5R | Capacitor_SMD:C_0805_2012Metric | C15850
C16 | 10u 25V X5R | Capacitor_SMD:C_0805_2012Metric | C15850
C17 | 10u 25V X5R | Capacitor_SMD:C_0603_1608Metric | C96446
C18 | 22u 25V X5R | Capacitor_SMD:C_0805_2012Metric | C45783
C19 | 22u 25V X5R | Capacitor_SMD:C_0805_2012Metric | C45783
C20 | 22u 25V X5R | Capacitor_SMD:C_0805_2012Metric | C45783
C21 | 10u 25V X5R | Capacitor_SMD:C_0603_1608Metric | C96446
R25 | 470R 1% | Resistor_SMD:R_0603_1608Metric | C23179
R26 | 0R initial RF tuning link | Resistor_SMD:R_0402_1005Metric | C17168
R27 | 10k 1% | Resistor_SMD:R_0603_1608Metric | C25804
C22 | 100n 50V X7R | Capacitor_SMD:C_0603_1608Metric | C14663
C23 | 100n 50V X7R | Capacitor_SMD:C_0603_1608Metric | C14663
C24 | 100n 50V X7R | Capacitor_SMD:C_0603_1608Metric | C14663
C25 | 100n 50V X7R | Capacitor_SMD:C_0603_1608Metric | C14663
