krisxia0506/voxu/hardware/enclosure-battery/stl/base.stl

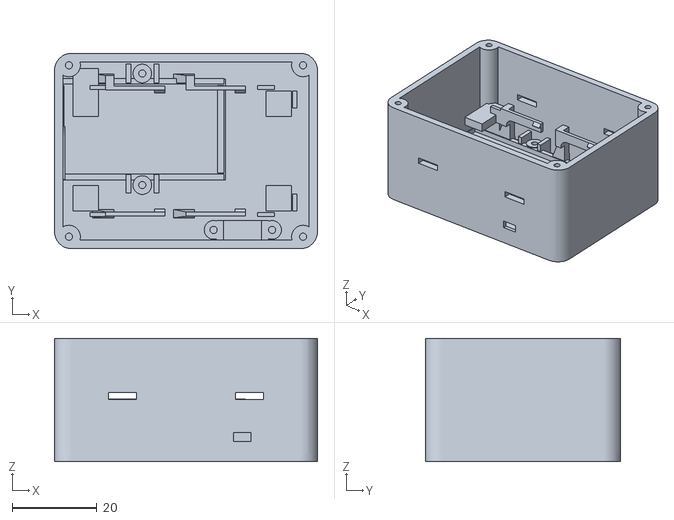
[picture p40: CAD file, 2026-10-20]
hardware/enclosure-battery/stl/base.stl
62.0 x 46.0 x 29.0
