krisxia0506/voxu/hardware/enclosure-battery/stl/button-pin.stl

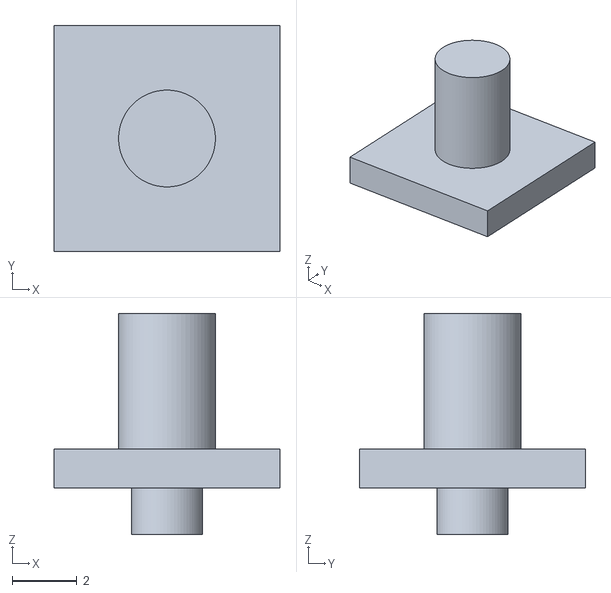
[picture p41: CAD file, 2026-10-19]
hardware/enclosure-battery/stl/button-pin.stl
7.00 x 7.00 x 6.85
