krisxia0506/voxu/hardware/enclosure-battery/stl/ups-clamp-left.stl

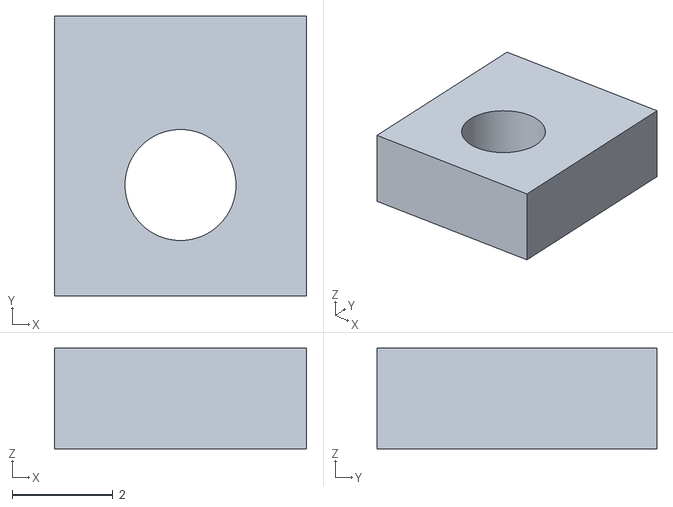
[picture p42: CAD file, 2026-10-19]
hardware/enclosure-battery/stl/ups-clamp-left.stl
5.00 x 5.55 x 2.00
