krisxia0506/voxu/hardware/enclosure-battery/stl/button-cap.stl

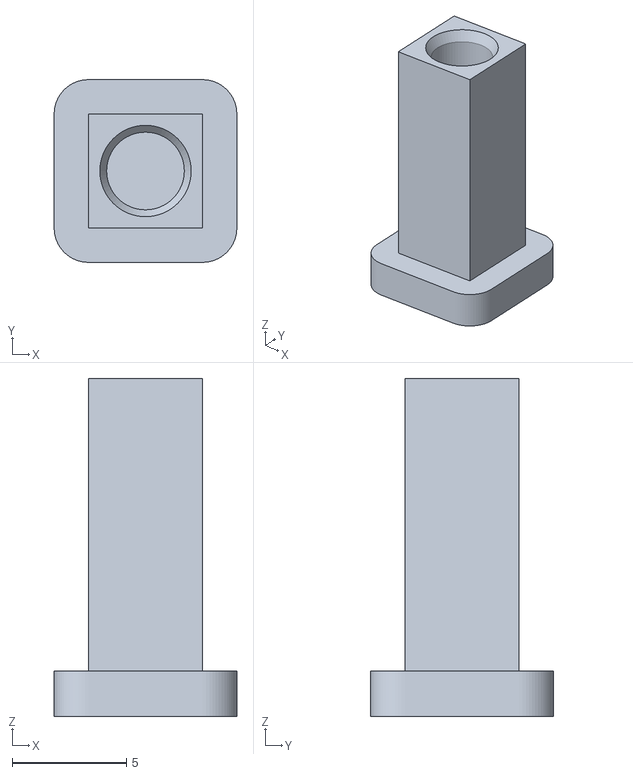
[picture p43: CAD file, 2026-10-19]
hardware/enclosure-battery/stl/button-cap.stl
8.00 x 8.00 x 14.8
