krisxia0506/voxu/hardware/enclosure-battery/stl/ups-clamp-right.stl

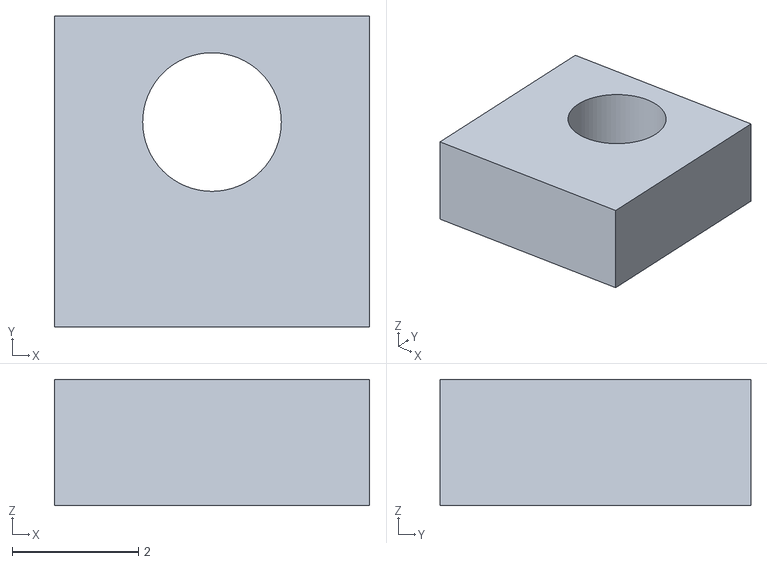
[picture p44: CAD file, 2026-10-19]
hardware/enclosure-battery/stl/ups-clamp-right.stl
5.00 x 4.93 x 2.00
