krisxia0506/voxu/hardware/enclosure-battery/stl/switch-retainer.stl

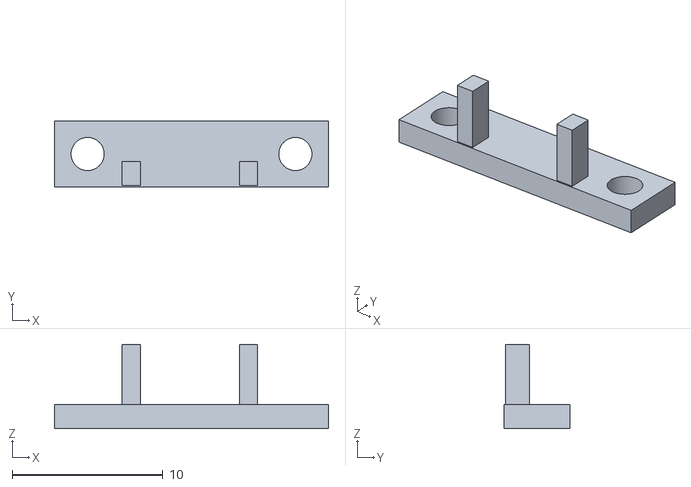
[picture p45: CAD file, 2026-10-19]
hardware/enclosure-battery/stl/switch-retainer.stl
18.2 x 4.40 x 5.60
