krisxia0506/voxu/hardware/enclosure-battery/stl/lid.stl

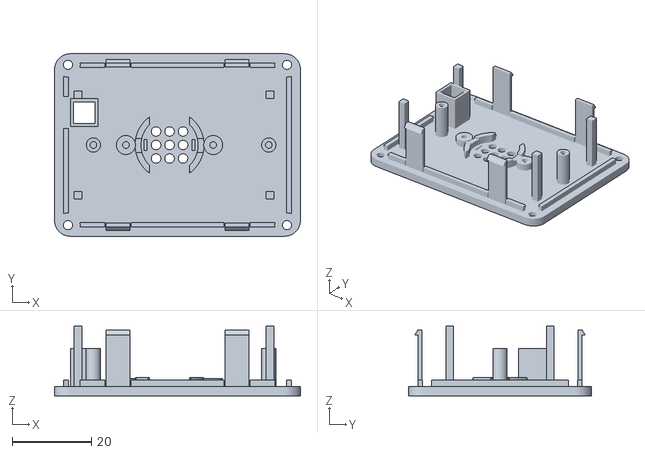
[picture p46: CAD file, 2026-10-19]
hardware/enclosure-battery/stl/lid.stl
62.0 x 46.0 x 17.6
