krisxia0506/voxu/hardware/enclosure-battery/stl/battery-tray.stl

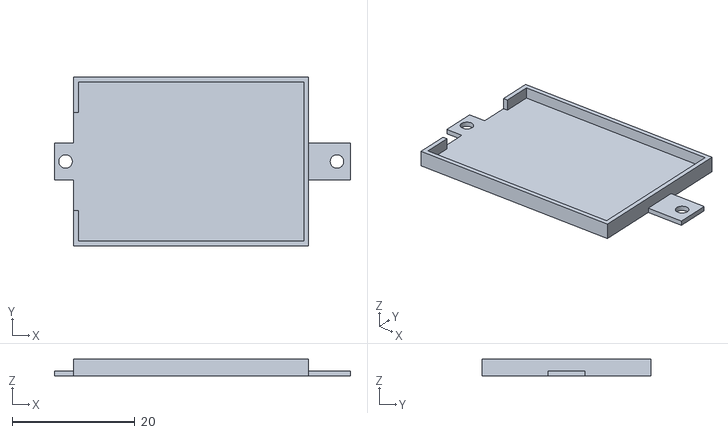
[picture p47: CAD file, 2026-10-19]
hardware/enclosure-battery/stl/battery-tray.stl
48.2 x 27.5 x 2.70
