krisxia0506/voxu/hardware/enclosure-battery/stl/mic-clamp.stl

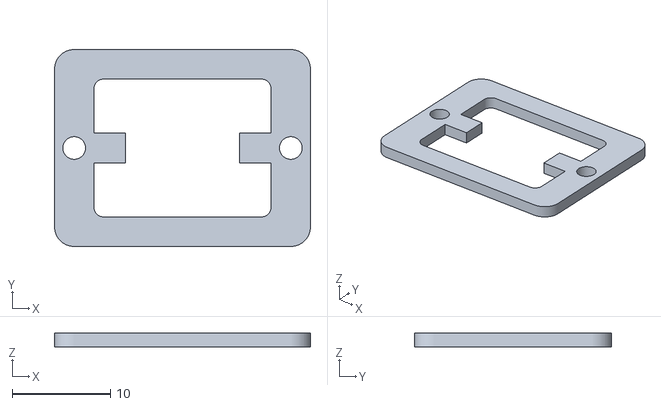
[picture p48: CAD file, 2026-10-19]
hardware/enclosure-battery/stl/mic-clamp.stl
26.0 x 20.0 x 1.40
