krisxia0506/voxu/hardware/enclosure/stl/lid.stl

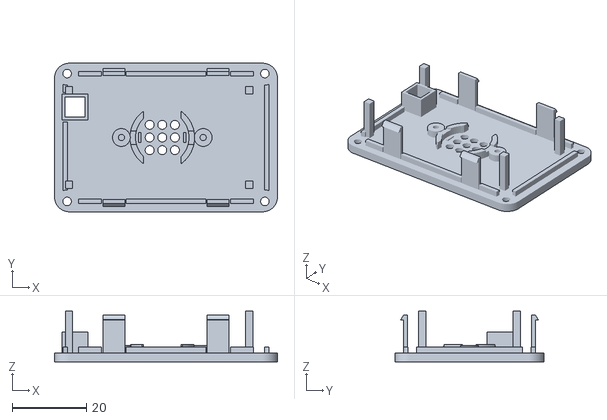
[picture p49: CAD file, 2026-09-30, an earlier design]
hardware/enclosure/stl/lid.stl
60.0 x 40.0 x 13.6
