krisxia0506/voxu/hardware/enclosure/stl/base.stl

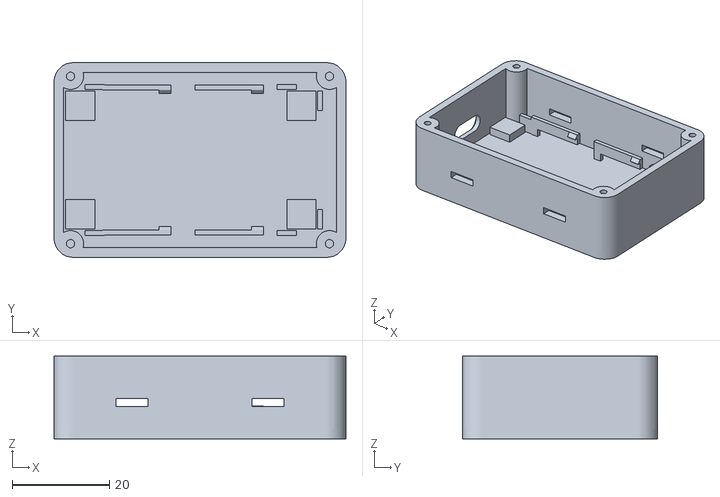
[picture p50: CAD file, 2026-09-30, an earlier design]
hardware/enclosure/stl/base.stl
60.0 x 40.0 x 17.0
