krisxia0506/voxu/hardware/enclosure/stl/button-cap.stl

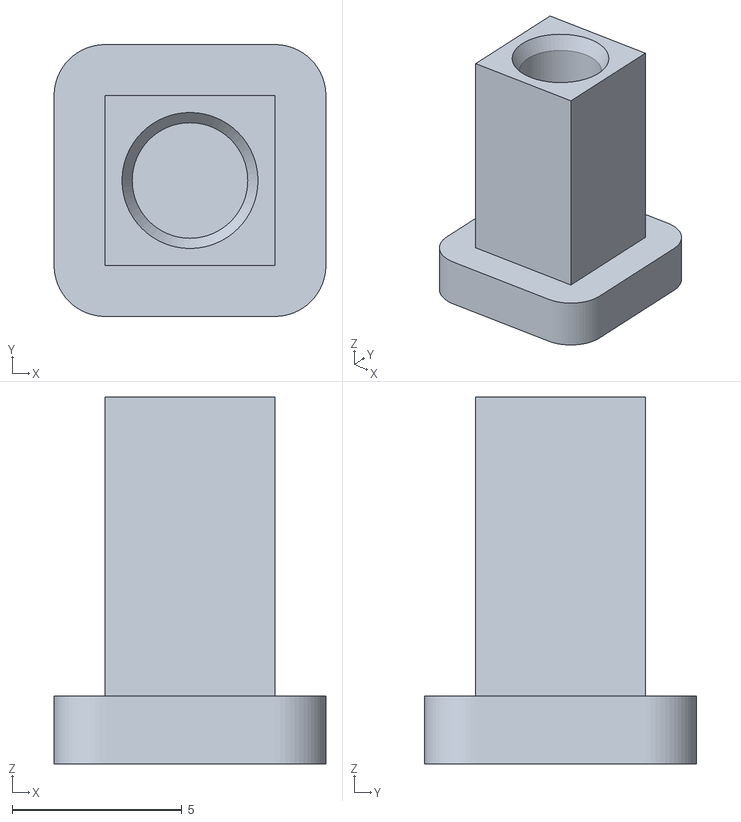
[picture p51: CAD file, 2026-09-30, an earlier design]
hardware/enclosure/stl/button-cap.stl
8.00 x 8.00 x 10.8
