krisxia0506/voxu/hardware/enclosure/stl/button-pin.stl

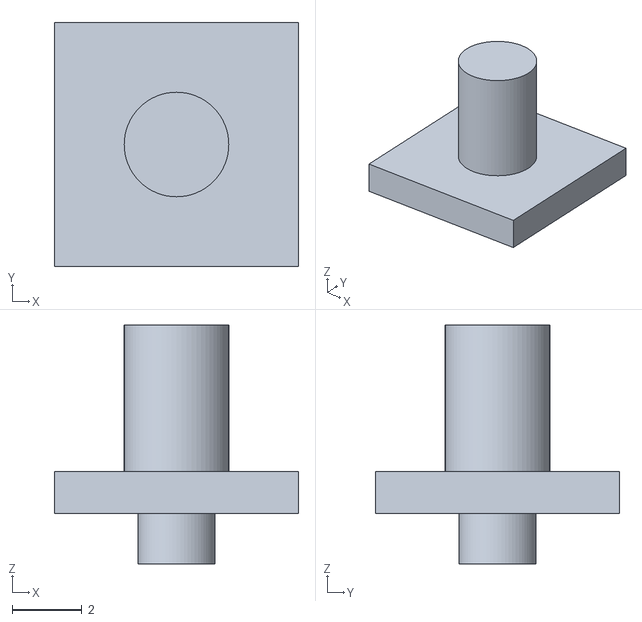
[picture p52: CAD file, 2026-09-30, an earlier design]
hardware/enclosure/stl/button-pin.stl
7.00 x 7.00 x 6.85
