krisxia0506/voxu/(list of files, cad)

Other CAD files:
hardware/enclosure/stl/mic-clamp.stl
