krisxia0506/voxu/hardware/integrated-pcba/lceda-pro/connector-manufacturing-review.md

# 连接器与开关制造检查（2026-10-23）

范围：检查当前原生工程封装与厂商机械图，不能替代输出 Gerber/钻孔文件核对和嘉立创装配审核。

## SW3：MSK12C02 / C431540

[首韩图纸](https://datasheet.lcsc.com/datasheet/pdf/5162155576bfd231c35aa9a893d25c8c.pdf)显示三个信号焊脚、四个外壳焊脚均为表面焊接，另有两个塑料定位柱。定位孔直径 0.85 mm、中心距 3 mm。供应商库名称包含 SW-TH 不能作为实际焊接方式依据。

发现导入封装仅有定位孔的顶/底阻焊开窗，缺少实际钻孔。已在工程封装中新增两个多层圆形挖槽，名义直径 0.85 mm，局部坐标 (−1.5, 0)、(+1.5, 0) mm。按 EDA 规则，它们应输出为 NPTH 钻孔，仍需核对实际输出文件。

移开与左侧孔相交的 GND 过孔至板坐标 (9, 1.9) mm，删除穿孔区域的六段接地支路，并重建双面地铜。原生 DRC 在 23:06:04 完成：141 项、0 问题。下载完整工程后逐记录核对：64 个元件和所有 PAD_NET 未变化，线路从 926 段变为 920 段，过孔仍为 86 个；仅一颗过孔位置变化，两个铺铜结果重建。

## J1：TYPE-C-31-M-12 / C165948

[HRO 图纸](https://datasheet.lcsc.com/datasheet/pdf/9e56b777c022540fcce7c7f67825f55e.pdf)和[JLC 元件页面](https://jlcpcb.com/partdetail/C165948)表明为表贴信号脚加穿板外壳固定脚，JLC 国际站列为 SMT Assembly；中国站最终装配匹配仍待审核。

当前封装包含两个 0.65 mm 非金属化定位孔和四个宽 0.60 mm 的金属化固定槽。两个短槽已从 1.20 mm 加长至图纸推荐的 1.40 mm，对应焊盘从 1.00 × 1.60 mm 增至 1.00 × 1.80 mm，保留名义 0.20 mm 环宽；另外两个长槽仍为 1.70 mm。定位孔比图纸的 0.60 mm 大 0.05 mm，孔位未改变。

扩大焊盘后 DRC 揭示底层 USB_TX 间距不足，已调整四段线的三个转角，保持 10 mil 线宽和 6 mil 间距规则。重建双面地铜后，2026-10-23 23:16:05 原生 DRC 141 项、0 问题。下载完整工程逐记录核对：64 个元件、全部 PAD_NET、86 个过孔与上一版一致，920 段线路中只有四段 USB_TX 改变。完整工程保存于 `../source-backups/2026-10-23-usb-slots/`。实际 PTH 钻孔和焊盘输出仍待核对，不能据此宣布装配审核完成。

## J2：B3B-PH-SM4-TB / C160353

[JST PH 官方资料](https://www.jst-mfg.com/product/pdf/eng/ePH.pdf)列为 SMT top-entry，3 针、2 mm 节距。当前三个信号焊盘和两个固定焊盘均为顶层表贴，无穿板焊接。最终电池线束须明确匹配 1=BAT+、2=NTC、3=GND，不能按线色假定极性。

## 未完成项

- NPTH/PTH 实际钻孔输出、锡膏开口和全板制造检查。
- 中国站实际 BOM/装配匹配及报价；用户暂不提交订单，未付款。
