krisxia0506/voxu/renders/voice-puck-printable-m-ribbed-shell.png

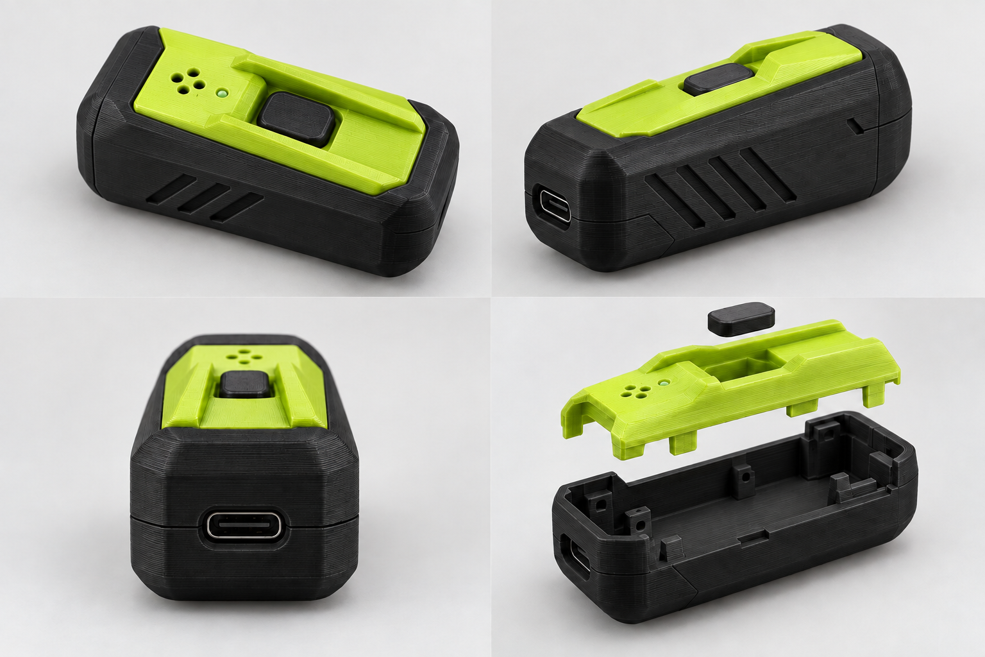
renders/voice-puck-printable-m-ribbed-shell.png
