krisxia0506/voxu/renders/voice-puck-printable-n-slider-shell.png

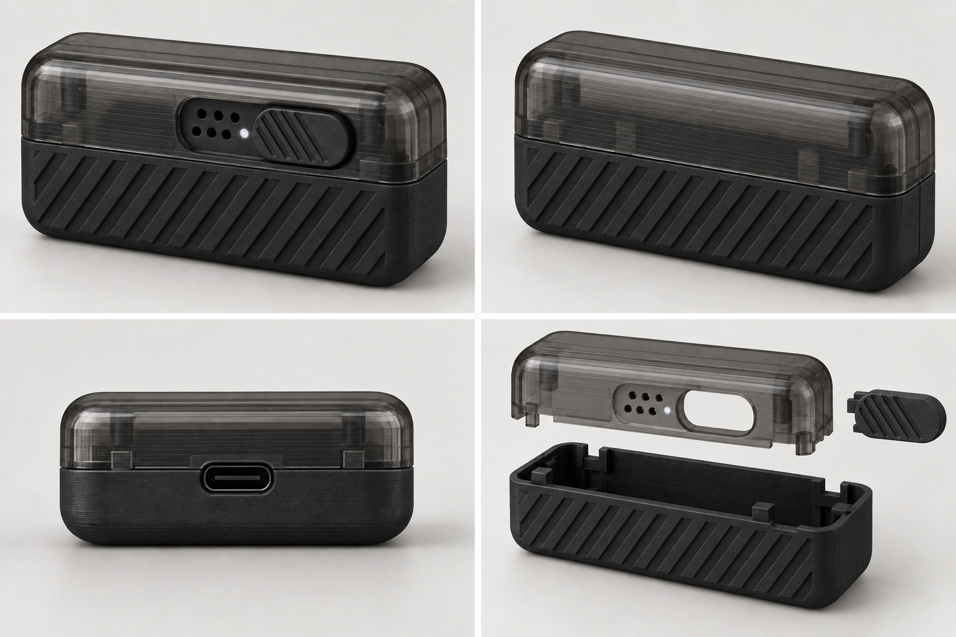
renders/voice-puck-printable-n-slider-shell.png
