krisxia0506/voxu/renders/voice-puck-printable-o-grip-shell.png

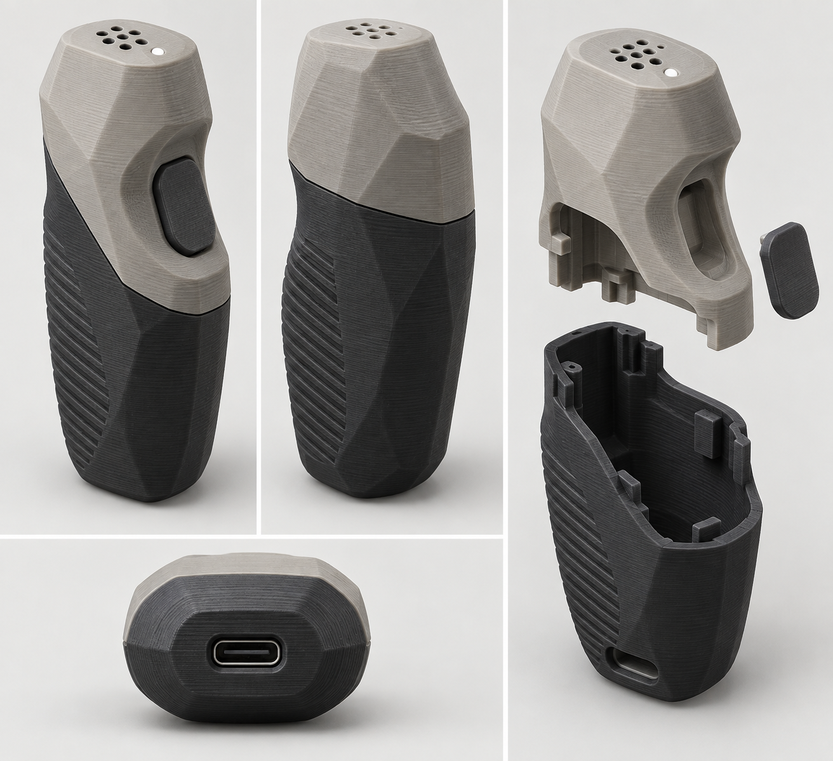
renders/voice-puck-printable-o-grip-shell.png
