krisxia0506/voxu/hardware/integrated-pcba/economy-e1/mainboard.kicad_sch

## KiCad design hardware/integrated-pcba/economy-e1/mainboard.kicad_sch (2026-10-24)

Schematic: mainboard.kicad_sch

Parts:
C1: 1u 50V X5R; C_0603_1608Metric; LCSC C15849
C2, C12, C13: 10u 10V X5R; C_0805_2012Metric; LCSC C15850
C3, C4, C6, C7, C8, C9, C10, C14: 100n 10V X7R; C_0603_1608Metric; LCSC C14663
C5, C11: 4.7u 10V X5R; C_0603_1608Metric; LCSC C19666
C15, C16: 10u 25V X5R; C_0805_2012Metric; LCSC C15850
C17, C21: 10u 25V X5R; C_0603_1608Metric; LCSC C96446
C18, C19, C20: 22u 25V X5R; C_0805_2012Metric; LCSC C45783
C22, C23, C24, C25: 100n 50V X7R; C_0603_1608Metric; LCSC C14663
D1: USBLC6-2SC6; SOT-23-6; LCSC C7519
J1: USB-C USB2 receptacle; LCSC C165948
J2: 1S protected battery + 10k NTC; LCSC C160353
L1: SMS0420-1R5MT 1.5uH; LCSC C5127348
Q1, Q2, Q3, Q4: MMBT3904; SOT-23; LCSC C20526
R1, R2, R4, R6, R9, R10, R11, R12, R13, R15, R16, R19, R20, R21, R27: 10k 1%; R_0603_1608Metric; LCSC C25804
R3, R14, R24: 100k 1%; R_0603_1608Metric; LCSC C25803
R5: 2.2k 1%; R_0603_1608Metric; LCSC C4190
R7, R8: 5.1k 1%; R_0603_1608Metric; LCSC C23186
R17: 3.9k 1%; R_0603_1608Metric; LCSC C23018
R18: 8.2k 1%; R_0603_1608Metric; LCSC C25981
R22: 470k 1%; R_0603_1608Metric; LCSC C23178
R23: 150k 1%; R_0603_1608Metric; LCSC C22807
R25: 470R 1%; R_0603_1608Metric; LCSC C23179
R26: 0R initial RF tuning link; R_0402_1005Metric; LCSC C17168
SW1: RESET push button; LCSC C720477
SW2: DICTATE / BOOT push button; LCSC C720477
SW3: RUN SPDT slide; LCSC C431540
U1: ESP32-PICO-V3; LCSC C967022
U2: SPH0655LM4H-1-8; MIC-SMD_SPH0655LM4H-1-8; LCSC C22376158
U3: CP2102N-A02-GQFN28; VOXU_CP2102N_QFN28; LCSC C964632
U4, U5, U6: SN74LVC2G125DCUR; VSSOP-8_2.3x2mm_P0.5mm; LCSC C21404
U7: BQ24075RGTR; VOXU_BQ24075_RGT0016C; LCSC C15464
U8: TPS63070RNMR; LCSC C109322

Connections:
3V3: C2.1, C3.1, C4.1, C8.1, C9.1, C18.1, C19.1, C20.1, C21.1, C22.1, C23.1, C24.1, C25.1, R1.1, R2.1, R9.1, R10.1, R11.1, R12.1, R22.1, U1.1 (VDDA), U1.3 (VDD3P3), U1.4 (VDD3P3), U1.19 (VDD3P3_RTC), U1.37 (VDD3P3_CPU), U1.43 (VDDA), U1.46 (VDDA), U2.5 (VDD), U4.8 (VCC), U5.7 (2OEn), U5.8 (VCC), U8.7 (VOUT), U8.8 (VOUT)
BAT: C12.1, J2.1 (BAT+), U7.2 (BAT), U7.3 (BAT)
BAT_NTC: J2.2 (NTC), U7.1 (TS)
BOOT_BASE: Q3.1 (B), R16.2
CC1: J1.A5 (CC1), R7.1
CC2: J1.B5 (CC2), R8.1
CHG_ALLOW_BASE: Q4.1 (B), R20.2
CHG_INHIBIT: Q4.3 (C), R19.2, U7.6 (EN1)
DTR_SYS: Q3.2 (E), R11.2, R15.1, U4.3 (2Y)
EN_BASE: Q2.1 (B), R15.2
ESP_BOOT: Q3.3 (C), R2.2, SW2.1, U1.23 (IO0)
ESP_EN: C1.1, Q2.3 (C), R1.2, SW1.1, U1.9 (EN)
ESP_RX: R10.2, U1.40 (U0RXD), U4.6 (1Y)
ESP_TX: U1.41 (U0TXD), U6.2 (1A)
FB: R22.2, R23.1, U8.5 (FB)
FLASH_VOLTAGE_STRAP: R27.1, U1.18 (IO12)
GND: C1.2, C2.2, C3.2, C4.2, C5.2, C6.2, C7.2, C8.2, C9.2, C10.2, C11.2, C12.2, C13.2, C14.2, C15.2, C16.2, C17.2, C18.2, C19.2, C20.2, C21.2, C22.2, C23.2, C24.2, C25.2, D1.2 (GND), J1.A1 (GND), J1.A12 (GND), J1.B1 (GND), J1.B12 (GND), J1.S1 (SHIELD), J2.3 (BAT-), Q1.2 (E), Q4.2 (E), R3.2, R6.2, R7.2, R8.2, R14.2, R17.2, R21.2, R23.2, R24.2, R25.2, R27.2, SW1.2, SW2.2, U1.49 (GND), U2.2 (SELECT), U2.3 (GND), U3.3 (GND), U3.29 (EP), U4.4 (GND), U5.4 (GND), U5.5 (2A), U6.1 (1OEn), U6.4 (GND), U6.5 (2A), U7.4 (CE), U7.8 (VSS), U7.15 (SYSOFF), U7.17 (EP), U8.1 (PS_SYNC), U8.4 (GND), U8.6 (FB2), U8.10 (PGND), U8.15 (VSEL)
ILIM: R17.1, U7.12 (ILIM)
ISET: R18.1, U7.16 (ISET)
ISET_SERIES: R18.2, R25.1
MIC_BCLK: U1.15 (IO26), U2.4 (CLOCK)
MIC_SD: R3.1, U1.13 (IO33), U2.1 (DATA)
RF_ANT: R26.2
RF_CHIP: R26.1, U1.2 (LNA_IN)
RTS_SYS: Q2.2 (E), R12.2, R16.1, U5.6 (1Y)
RUN_EN: R24.1, SW3.2 (COMMON), U8.14 (EN)
SW_L1: L1.1, U8.11 (L1)
SW_L2: L1.2, U8.9 (L2)
SYS: C13.1, C15.1, C16.1, C17.1, SW3.1 (ON), U7.10 (OUT), U7.11 (OUT), U8.12 (VIN), U8.13 (VIN)
USB_3V3: C5.1, C6.1, C10.1, R4.1, R19.1, U3.6 (VDD), U6.7 (2OEn), U6.8 (VCC), U7.5 (EN2)
USB_ALLOW_500: R20.1, R21.1, U3.15 (CHR0)
USB_DM: D1.3 (IO2), D1.4 (IO2), J1.A7 (DM), J1.B7 (DM), U3.5 (DM)
USB_DP: D1.1 (IO1), D1.6 (IO1), J1.A6 (DP), J1.B6 (DP), U3.4 (DP)
USB_DTR: U3.28 (DTR), U4.5 (2A)
USB_ISO_OEn: Q1.3 (C), R9.2, U4.1 (1OEn), U4.7 (2OEn), U5.1 (1OEn)
USB_PRESENT_BASE: Q1.1 (B), R13.2, R14.1
USB_RESET: R4.2, U3.9 (RST)
USB_RTS: U3.24 (RTS), U5.2 (1A)
USB_RX: U3.25 (RXD), U6.6 (1Y)
USB_TX: U3.26 (TXD), U4.2 (1A)
VAUX: C14.1, U8.3 (VAUX)
VBUS: C7.1, C11.1, D1.5 (VBUS), J1.A4 (VBUS), J1.A9 (VBUS), J1.B4 (VBUS), J1.B9 (VBUS), R5.1, R13.1, U3.7 (VREGIN), U7.13 (IN)
VBUS_SENSE: R5.2, R6.1, U3.8 (VBUS)
