krisxia0506/voxu/hardware/integrated-pcba/schematic/microphone.kicad_sch

## KiCad design hardware/integrated-pcba/schematic/microphone.kicad_sch (2026-10-23)

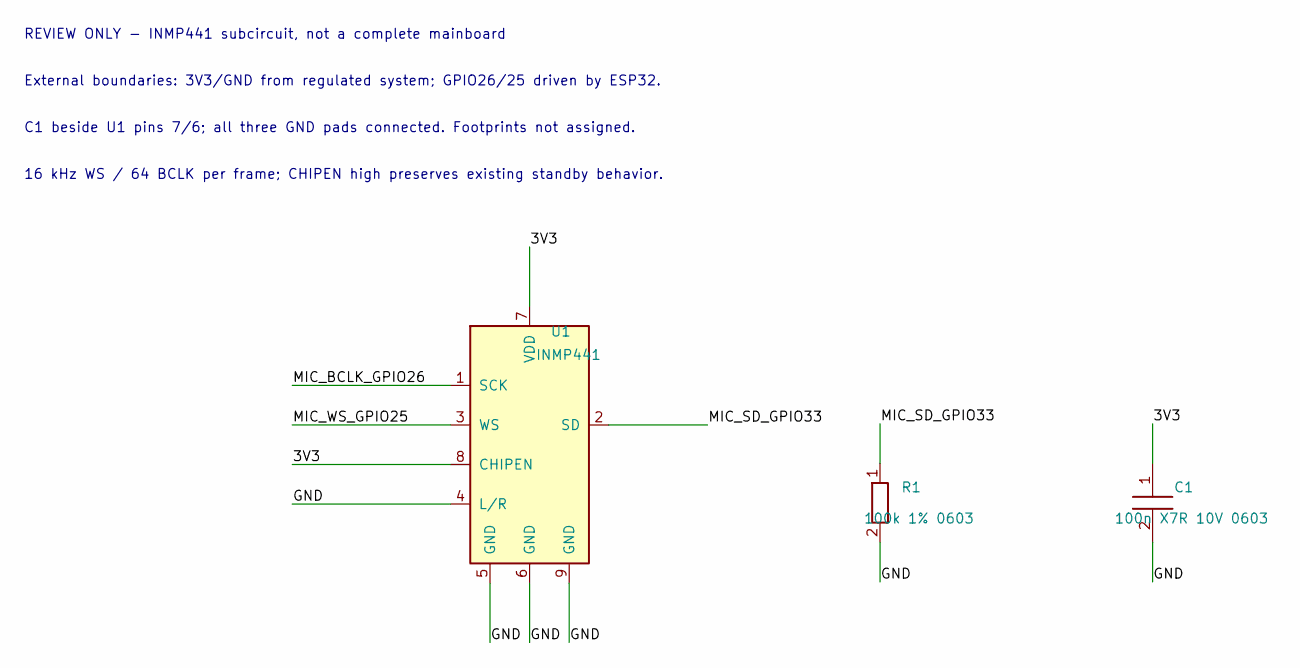
[picture p56: schematic microphone.kicad_sch]

Parts:
C1: 100n X7R 10V 0603
R1: 100k 1% 0603
U1: INMP441

Connections:
3V3: C1.1, U1.7 (VDD), U1.8 (CHIPEN)
GND: C1.2, R1.2, U1.4 (L/R), U1.5 (GND), U1.6 (GND), U1.9 (GND)
MIC_BCLK_GPIO26: U1.1 (SCK)
MIC_SD_GPIO33: R1.1, U1.2 (SD)
MIC_WS_GPIO25: U1.3 (WS)

Notes on the sheet:
REVIEW ONLY - INMP441 subcircuit, not a complete mainboard
External boundaries: 3V3/GND from regulated system; GPIO26/25 driven by ESP32.
C1 beside U1 pins 7/6; all three GND pads connected. Footprints not assigned.
16 kHz WS / 64 BCLK per frame; CHIPEN high preserves existing standby behavior.
