krisxia0506/voxu/(commit log)

2026-09-29 初始化 Voice Puck V1 项目资料与验证固件
2026-09-29 feat: 用 BOOT 发送 Typeless 蓝牙快捷键
2026-09-29 fix: 使用单键 F13 并补齐 HID 初始化参数
    [boot_hid.c]
2026-09-29 docs: 明确 F13 验证范围与断线边界
2026-09-29 docs: 记录 BOOT F13 与 Typeless 实物验收
2026-09-29 feat: 添加 P2S 有线外壳与 BOOT 按压件试装模型
    [base.stl, board-fit-test.stl, button-cap.stl, button-guide-test.stl, button-pin-long.stl, button-pin-short.stl, button-pin-standard.stl, lid.stl]
2026-09-29 docs: 补齐按钮运动验证、实际模型预览及 P2S 切片证据
2026-09-29 fix: 去除上盖护脊以支持平面朝下无支撑打印
    [lid.stl]
2026-09-29 fix: 放宽 BOOT 按帽连接孔并添加插入导角
    [button-cap.stl]
2026-09-29 feat: 重做焊线叠放外壳并改善麦克风固定、按钮导向及 USB 开孔
    [base.stl, board-fit-test.stl, button-cap.stl, button-guide-test.stl, button-pin-long.stl, button-pin-short.stl, button-pin-standard.stl, lid.stl]
2026-09-29 chore: 移除外壳试装测试组件并精简打印包
    [board-fit-test.stl, button-guide-test.stl, usb-front-test.stl]
2026-09-29 feat: 增大 ESP32 托台并添加卡扣定位，默认使用最长顶杆
    [base.stl, button-pin-short.stl, button-pin-standard.stl, button-pin.stl]
2026-09-29 fix: 开机直接连接蓝牙并在断线后重试
2026-09-29 fix: 持久记住上次连接设备并同步 HID 目标
    [boot_hid.c, boot_hid.h, hfp_reconnect.c, hfp_reconnect.h, main.c]
2026-09-29 fix: 为蓝牙连接碰撞卡死添加超时恢复
2026-09-29 feat: 添加可解锁的上下壳卡扣并保留螺丝加固孔
    [base.stl, lid.stl]
2026-09-29 docs: 记录上次设备重连和碰撞恢复实测
2026-09-30 docs: 明确单 USB-C 电池版电源和外壳设计规格
2026-09-30 docs: 改为单 USB-C 自动充电与刷机要求
2026-09-30 docs: 核实 MacBook USB-C 自动充电模块与启动约束
2026-09-30 docs: 绘制电池版分层布局并明确自动检测控制提案
2026-09-30 docs: 记录已连接 WCH 设备的只读 USB 电流描述符
2026-09-30 docs: 明确充电输入限流元件与热设计预算
2026-09-30 docs: 改为紧凑定制电源板并扩展充电兼容范围
2026-09-30 docs: 固定初代外壳长宽并核实一体电源板与小电池约束
2026-09-30 docs: 用初代CAD核对同长宽电池布局及天线间距
2026-09-30 docs: 记录实测供电节点并修正关机充电接法
2026-10-10 feat: 添加同长宽电池外壳试装件及CH340供电候选
    [base.stl, battery-tray.stl, button-cap.stl, button-pin.stl, lid.stl, mic-clamp.stl]
2026-10-18 docs: 记录 VOXU V2 版本与材料清单
2026-10-18 feat: 按实物一体 UPS 和 550mAh 电池适配外壳
    [base.stl, battery-tray.stl, button-cap.stl, button-pin.stl, lid.stl, mic-clamp.stl]
2026-10-18 fix: 加固主板卡扣根部并添加交互拆解预览
    [base.stl]
2026-10-18 feat: 居中外露 UPS 充电口并隐藏刷机口
    [base.stl, battery-tray.stl, button-cap.stl, button-pin.stl, lid.stl]
2026-10-18 docs: 增加动态接线图与刷机断电步骤
2026-10-18 fix: 为UPS增加硬限位压片和右侧开关安装座
    [base.stl, switch-retainer.stl, ups-clamp-left.stl, ups-clamp-right.stl]
2026-10-18 docs: update verified external UPS switch wiring
2026-10-18 fix: 无音频连接时暂停麦克风采集
2026-10-18 feat: show mounting screws in assembly preview
2026-10-18 feat: highlight assembly parts and show screw details on hover
2026-10-18 feat: group assembly screw visibility by mounting location
2026-10-18 fix: correct UPS mount handedness from measured USB offset
    [base.stl, ups-clamp-left.stl, ups-clamp-right.stl]
2026-10-18 feat: annotate board component faces and USB connector positions
2026-10-18 feat: show raised board components with direct USB labels
2026-10-19 fix: resize UPS mount for remeasured PCB dimensions
    [base.stl, ups-clamp-left.stl]
2026-10-20 fix: reinforce V2 ESP32 clip elbows
    [base.stl]
2026-10-23 chore: 添加分用途许可证并完善隐私清理
2026-10-23 docs: 更新历史清理后的验证记录引用
2026-10-23 docs: 添加原型外壳与电池接线实拍图
2026-10-23 docs: 建立两块集成主板设计评审稿与费用模型
2026-10-23 docs: 补充可追溯候选料号与贴片供货状态
2026-10-23 docs: 核实五颗核心器件供货并修订两板预算
2026-10-23 feat(hardware): 优先 INMP441 并建立麦克风子电路
    [microphone.kicad_sch]
2026-10-23 hardware: add full-board electrical draft and power checks
    [mainboard-bom-draft.csv, mainboard.kicad_sch]
2026-10-23 hardware: migrate electrical draft to LCEDA Pro and quote one board
    [mainboard-bom-draft.csv, mainboard.kicad_sch]
2026-10-23 hardware: bind 47 LCEDA footprint candidates and record remaining errors
2026-10-23 完成整板封装绑定及原生 PCB 初步布局
    [mainboard-bom-draft.csv, mainboard.kicad_sch]
2026-10-23 完成整板布线及三维模型并记录制造报价阻断
2026-10-23 同步电气检查报告的 PCB 审核状态
2026-10-23 压缩主板到45x37毫米并完成重新布线检查
2026-10-23 补齐64个位号的采购候选与嘉立创库存核价
    [bom-review.csv]
2026-10-23 保存原生贴片坐标并更新紧凑版嘉立创报价证据
    [compact-cpl-native.csv]
2026-10-23 记录嘉立创现货麦克风选型与 PDM 替换约束
2026-10-23 增加 SPH0655 PDM 主板固件构建配置
2026-10-23 替换现货 SPH0655 麦克风并完成紧凑主板布线检查
    [bom-review.csv, mainboard-bom-draft.csv, mainboard.kicad_sch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]
2026-10-23 统一采购与坐标 CSV 换行格式
    [bom-review.csv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]
2026-10-23 备份完整立创 EDA 原生工程及恢复说明
2026-10-23 修正麦克风声孔制造间距并备份原生工程
2026-10-23 补齐电源开关定位孔并调整孔区接地连接
2026-10-23 修正USB固定槽尺寸并避让相邻信号线
2026-10-24 将Type-C移至短边居中并重新布线和导出装配模型
    [compact-cpl-native.csv]
2026-10-24 规范化原生贴片坐标文件换行
    [compact-cpl-native.csv]
2026-10-24 记录新版嘉立创报价参数及焊盘网络一致性核对
2026-10-24 整理整板七视角预览并修正侧视图裁切
2026-10-24 明确CP2102N充电配置工序及厂商烧录费用边界
2026-10-24 docs: 记录嘉立创审核单及完整贴片报价
2026-10-24 docs: 更新 SMT 最终提交页状态
2026-10-24 docs: 核算经济型方案并落实两块160元制作上限
2026-10-24 docs: 记录盲盒券结果与免换料费清单核算
    [free-feeder-audit.csv]
2026-10-24 docs: 记录全部位号降本试算及制造限制
    [cost-trial-all-parts.csv]
2026-10-24 hardware: 新增 PICO-V3 经济型电气候选与完整 BOM
    [bom-candidate.csv, mainboard.kicad_sch]
2026-10-24 hardware: 记录经济型两板全BOM预算与制造阻断项
    [costed-bom.csv]
2026-10-24 hardware: 评估杰理主控与免换料电源替代路线并核验预算下界
    [selection.csv]
2026-10-24 hardware: 记录公开SDK构建探测与低价三针插座候选
    [selection.csv]
2026-10-24 hardware: 修正杰理演示配置并验证512KiB构建探测
2026-10-24 hardware: 核验小批量整盘采购的实际增量成本
